NormanStaub/naub/firmware/v2/README.md

# naub V2 firmware toolkit

Everything learned from the display/grayscale/motion bring-up experiments
(2026-09, Windows host), packaged as reusable modules for building the real
UI. CircuitPython 10.3.0 on the Waveshare RP2350-Tiny.

```
device/   modules that live on the CIRCUITPY drive (pure CircuitPython)
  boot.py      enables the 2nd USB CDC (data) port -- needs a POWER CYCLE
  st7565.py    ST7565R driver: full-frame, partial-span, FRC-friendly
  link.py      host<->device line protocol over the data port
  naubhw.py    board wiring: display, backlight, 4 encoders, 9 switches
  gfx.py       1-bit page framebuffer + text/icon drawing (runs on PC too)
  mixer.py     the mixer screen: 3 columns, 8-band dot meters, the mode bar
  drawer.py    the app switcher: a dropdown over the meters (pure Python too)
  media.py     transport keys over USB HID -- no library, no host software
  idle.py      backlight: full while in use, 10% after 1 min, off after 5
  wheel.py     which apps the switcher offers, and for how long
  ballistics.py how every meter moves: one home for FALL/PEAK_FALL/PEAK_GAP
  config.py    the CONFIG screen: settings in tabs, driven by the three knobs
  ccfont.py    C&C Red Alert font (TINY h8 full ASCII, SML h16, BIG digits h27)
demos/    ready-to-flash examples (each becomes code.py) + generated data
  demo_mixer.py       the mixer screen + the app-switcher dropdown  <- the UI
  demo_app_icons.py   open-app icons in 4-plane FRC grayscale (static screen)
  demo_gray_modes.py  8 grayscale techniques on one knob (the experiment)
  demo_ball.py        bouncing ball, dirty-span updates (refresh/motion test)
host/     PC-side tools (Python 3 + Pillow, pyserial optional)
  deploy.py       python deploy.py mixer|icons|gray|ball -> copies to K:, watches serial
  frc.py          THE reusable piece: ink levels / PIL image -> FRC bitplanes
  naub_bridge.py  streams real audio to the device; applies knob moves back
  appmeter.py     per-app audio level / volume / mute from WASAPI
  appscan.py      enumerate open apps + extract their icons (Windows)
  gen_switcher.py regenerates demos/switcher_data.py (movable per-tier icons)
  gen_appicons.py regenerates demos/appicons.py (one baked screen)
  gen_grad.py     regenerates demos/graygrad.py (gradient planes)
  gen_font.py     TTF -> ccfont.py (extract repo-root c_c_red_alert_inet.zip
                  into host/font_src/ first)
  preview_mixer.py / preview_drawer.py / preview_gray.py      previews
  gdifont.py      render text with Windows GDI -- reaches BITMAP (.FON) faces
  preview_fonts.py  candidate faces at panel scale -> fonts_preview.png
  draw_logos.py / gen_icon.py                                 binary icons
```

## Display: ST7565R (EA DOGM128W-6, 128x64 STN)

Pins: A0=GP8 CS=GP9 SCL=GP10 SI=GP11 RST=GP12, backlight FET on GP13 (PWM).

The white backlight is also the part that wears out: Display Visions rate the
yellow/green, red and amber at 100,000 hours and say the white and blue are
"considerably shorter", recommending they be dimmed or switched off whenever
possible. The idle fade below is that recommendation, automated.

The backlight dims itself (`device/idle.py`): full while you are using it,
10% one minute after the last knob or key, off after five, fading between —
1.2 s down, 0.1 s back up, because settling should be unhurried and waking
should not. The fade interpolates in perceptual space (duty ** 1/2.2), since a
straight line in PWM duty looks like it plummets and then dawdles. The panel
keeps drawing the whole time; only the light goes.
Init = EA "single supply 3.0/3.3 V" sequence (see `st7565.py`). Config knobs
on the constructor / `naubhw.display()`:

| knob | default | notes |
|---|---|---|
| `baudrate` | 8 MHz | verified clean on hardware; 4 MHz also fine |
| `contrast` | 31 | user-tuned for FRC grays at BL 80% (26 tested at BL 100%) |
| `orient_180` | True | panel is mounted upside-down in the case |
| `col_offset` | derived | **must follow the orientation** — see below |

**`col_offset` depends on `orient_180`.** The ST7565R has 132 columns of RAM but
this panel wires only 128 of them, as SEG4..SEG131. With ADC reversed (`0xA1`,
the non-flipped case) column address 0 lands on SEG131, so the window starts at
0; with ADC normal (`0xA0`, the flipped case) it lands on SEG0 and the window
must start at **4**. Hard-coding 0 shifts the image 4px and paints 4 columns of
stale RAM at one edge — invisible on screens with blank margins, glaring on one
that draws edge to edge, which is how the mixer screen finally exposed it.
Leave `col_offset=None` and the driver derives it.

Framebuffer: `bytearray(128*8)`, `index = page*128 + x`, bit `1<<(y&7)`,
LSB = top. `gfx.py` is pure Python and runs identically on CPython, so PC
previews are pixel-exact (WYSIWYG workflow — always preview before flashing).

### Measured performance (RP2350-Tiny, CircuitPython 10.3.0)

| operation | rate |
|---|---|
| full-frame `show_pages()` @ 8 / 16 / 32 MHz | 572 / 900 / 1175 fps |
| full-frame `show()` @ 8 MHz (slices per page — allocates) | 463 fps |
| raw 1024-byte SPI write @ 8 MHz (the floor) | 1.31 ms |
| partial `span()` (16px sprite, 2 pages) @ 8 MHz | ~2200 updates/s |
| `drawer.compose()` open / mid-slide | 0.41 ms / 4.2 ms |
| `mixer.draw_dots()` (24 bands + peak markers) | 1.2 ms |
| `mixer.update()` + `draw_dots()` together | 4.5 ms |
| `eqscreen.update()` + `draw_plot()` (meter only) | 3.7 ms |
| poll 4 encoders + 9 switches | 0.056 ms |
| whole UI, paced to the panel (was 359-390 free-running) | 92.3 Hz |
| `time.monotonic()` granularity at 1.5 h uptime | 0.488 ms |
| `time.monotonic_ns()` granularity | 0.122 ms |
| USB CDC receive ring | ~200 bytes |
| free RAM with mixer + switcher loaded (8 apps, 2 tiers) | 358 kB |

**The panel refreshes at ~77 Hz, and that is a hard cap.** The ST7565R scans
the glass from its own RC oscillator (fOSC 20 kHz typ, 17-24 min/max) and at
1/65 duty the liquid crystal frame rate is `fOSC / (4 * 65)` = **76.9 Hz typ,
65-92 Hz over tolerance** (ST7565R datasheet Tables 19 and 23). It free-runs,
unsynchronised to our writes, and cannot be changed — an external clock needs
CL/CLS and the DOGM128 module does not bring them out. Everything above is a
data-delivery rate: at 360 fps we rewrite the RAM ~4.7 times per displayed
frame. Nothing faster than ~77 Hz can appear as a distinct frame, which is
exactly the effect the FRC grayscale exploits.

The practical consequence: the 16 ms UI tick (62.5 Hz) is already within a
whisker of the ceiling. Shortening it buys at most ~20% more distinct frames
before the glass, not the code, becomes the limit.

So the frame loop is **paced to 92.3 Hz** — the top of the panel's tolerance,
so a fast part is still fed everything it can show, and nothing is spent on
frames no panel could display. It free-ran at 359-390 fps, i.e. it rewrote the
controller's RAM about five times per displayed frame. Two things the pacing
had to get right:

* **Paced per push, not per cycle.** The FRC grays *are* the share of time each
  plane spends on screen, so idling at the end of a cycle — holding the last
  plane through the gap — would tint them. One plane, one slot: 92 Hz for a
  binary screen, 4 × 92 for the drawer.
* **Timed in `monotonic_ns()`.** Every pacing loop tried (single sleep, sliced,
  sleep-then-spin) landed on 96.2 Hz instead of 92.3, which looked like a bug in
  the loop and was the clock — see below.

And one consequence: the idle time has to be spent, not just slept through. The
USB CDC receive ring holds ~200 bytes and the host's resync burst fills it, so
the loop wakes every 2 ms to empty the port and parses the lines on the next
frame. Backlog on connect went from 200 bytes to 25 in steady state.

### What runs where

The split is not "whatever is easiest": the host is somebody's PC doing other
work, and the panel has a whole core idle between frames.

| | where | why |
|---|---|---|
| WASAPI sessions, volume, mute, per-app peaks | host | only Windows has them |
| Column assignments (pins) | host | must outlive a device reload, and every deploy is one |
| **Which apps the switcher offers** | **device** | per-app timers at a few Hz — the host would have to keep the same state and stream its conclusions |
| Meter ballistics, marquee, easing, FRC | device | pixels are the device's job |
| EQ response curve | device | 3 biquads evaluated on a 128-column grid, redrawn per detent |
| EQ filtering itself | host | Equalizer APO is the engine; the panel is its control surface |
| System spectrum (FFT) | host | needs the audio; **only runs while the EQ screen is up** |

Measured, streaming to a live panel (4 s samples, one app playing):

| panel is showing | sends / 4 s | bytes/s |
|---|---|---|
| mixer, switcher shut | `meter` 126, `ameter` 19 | 457 |
| mixer, switcher open | `meter` 126, `ameter` 126 | 728 |
| EQ screen | + `smeter` 125 | 2341 |

`ameter` drops to 5 Hz with the switcher shut because that is all the device
needs to time how long each app has played — 85% fewer sends, and 85% fewer
per-app peak polls on the PC, for no visible difference. The loopback capture
starts and stops with the EQ screen: measured **62–79 ms to start**, inside the
220 ms mode wipe, so the spectrum is there by the time the screen finishes
sliding in.

### The CONFIG screen

**Adding settings: see [CONFIG_MENU.md](CONFIG_MENU.md).** What is still a
placeholder, and what is not built at all: [STATUS.md](STATUS.md).

The fourth mode. Three knobs, three jobs, labelled across the top of the screen
because that is the affordance: **ENC1 the tabs, ENC2 the cursor, ENC3 the
focused value** — turned live, with no arming and no commit step. A hidden edit
mode is what makes people change settings they did not mean to, and there is no
room on 128×64 to show which state you are in.

A setting is a tuple, and adding one is a line:

```python
(name, kind, key, spec, default, art)
('DISPLAY VIEW ANGLE', ENUM, 'view_angle', ANGLES, 4, ANGLE_ART)
```

`spec` is whatever the kind needs (ENUM a tuple of labels, PCT a `(lo, hi,
step)`, BOOL nothing, INFO the string). Exactly one function knows what a kind
looks like and one more knows what a detent does to it; nothing else has a
special case. `key` is a string from the start, because the row order will
change and position is the wrong handle the day a value is sent to the host or
written to disk. `art` is a tuple of pictures indexed **by the value** — the
whole view-angle flipbook is `art[val]`, no logic.

Rows are **16 px, which is two pages**: name on the top line, marker and value
below, a picture spanning both on the right. Two rows show in full and a third
shows its top half, which is also how you can tell there is more below. Because
16 is a multiple of 8, scrolling a whole row is still a byte-slice blit — the
same reason every other screen here is cheap.

Nothing on this screen is on a timer. The mixer and EQ redraw on a 16 ms tick
because their meters move; a settings list changes when a knob does and not
otherwise, so it redraws on input and the loop pushes the same bytes in
between. Measured on the board: full render 4.6 ms, a SCROLL detent 0.8 ms, a
SELECT detent 3.4 ms (it rebuilds that row's strip), and the screen costs
7.5 kB with 322 kB still free.

`DISP > ADVANCED DISPLAY` is a submenu (SELECT-click to enter, MENU NAV to
leave) holding the ST7565R registers the bring-up swept by hand — contrast,
resistor ratio, bias, booster, invert, all-pixels-on, start line. They are
**live**: turning the knob writes the register. Every value of every one has
been swept on the hardware; two of them (contrast 0, ALL PIXELS ON) black the
panel out, and the way back is the knob you just turned, since the cursor does
not move. BRIGHTNESS drives the real backlight.

`DISPLAY VIEW ANGLE` **is the contrast register**, mapped: measured 25 looking
down at the panel on a desk, 40 from an extremely shallow angle, interpolated
over nine steps. The two rows agree in both directions — the friendly one
writes the raw one, and turning the raw one moves the friendly one to whatever
it now means. Panel default contrast is 25, top and bottom of that same range.

`SYS > GITHUB` is a **card** — a page that is a picture rather than a list. It
shows the repo's QR code beside the link it encodes,
`https://github.com/NormanStaub/naub`. Both, not either: the code is the point
on a panel with no keyboard, but a QR is unreadable to a person, so if it will
not scan — or you are looking at a photograph of the panel — the text is the
only thing that says where it goes.

The code is drawn at **one pixel per module**, which is not a choice. 37 modules
(a version-3 code plus the 4-module quiet zone the spec requires) is already 37
of this window's 40 pixel rows, so there is no room to scale it and it has to
earn its scannability from contrast rather than size. `host/gen_qr.py` bakes
`device/qrdata.py` from `firmware/naub_qr-code.png` and **verifies what it is
baking** — a QR is opaque, so shipping the wrong URL is a mistake you would
otherwise find with a phone. The rendered framebuffer has been decoded back to
the URL as a test.

`SHADING` cycles the grayscale modes from the bring-up experiment, with a
little waving flag beside it that **cycles while the row is highlighted** — a
black-to-white gradient in a band displaced by a sine, 16 phases of it.

The gradient is `host/frc.py`'s encoder transcribed onto the device, so the
patch shows what the switcher's icons will actually look like rather than an
impression of them — which is why the config screen runs **four FRC planes**.
The modes offered are the frame counts that divide that cycle (`1F SPATIAL`,
`2F TEMPORAL`, `4F HYBRID`); a 3-frame pattern inside a 4-frame loop repeats a
frame and shows the wrong grey. Nothing is wired to the setting yet.

Measured with the flag on screen: an **85 Hz grey cycle**, above the panel's own
77 Hz. Getting there meant redrawing only the list for animation frames
(`render()` on all four planes is 21 ms and dropped it to 62 Hz), composing the
list once into a scratch rather than per plane, and hoisting the patch
overlay's page arithmetic out of its column loop (4.9 ms → 2.4). When no grey is
on screen the loop pushes one plane instead of four.

The list **scrolls smoothly**, which is the one place this screen leaves the
page grid: mid-slide the window sits at an offset that is not a multiple of 8,
so the blit shifts bits and costs 7.7 ms against 1.9, for the dozen frames a
scroll lasts. It still fits the 10.8 ms the loop is paced to. A tab or submenu
change snaps instead — sliding between two different lists is motion that means
nothing. DIM AFTER and the SYS/OS rows remain
placeholders in the right shape, so the list, the scrolling and the tabs have
something to be tested against.

### One program is not one session

Discord runs six processes and holds a render session from more than one of
them; measured in a call, pid 5724 was ACTIVE with a peak of 1.0 while pid
14168 sat idle at 0.0. `appmeter` used to key a dict by program name and
*assign* into it, so it kept whichever the enumeration returned last — measured
six times out of six, the idle one. That is the whole of "Discord is in the
list but has no level and the knob does nothing".

Sessions are now grouped per program: the level is the loudest of them, and a
volume or mute goes to **all** of them, because which one is audible changes
from call to call. Reproduced deterministically with two same-named processes,
one silent and one playing, the silent one enumerated last:

```
pid 36340 ACTIVE peak 0.000     OLD (kept the last session)  -> level 0.000
pid 40632 ACTIVE peak 0.275     NEW (loudest of the group)   -> level 0.559
```

All output endpoints are enumerated too, not just the default — apps can be
pointed anywhere and this machine has fifteen active ones. That is also the
cheaper path: pycaw's `GetAllSessions()` rebuilds its COM plumbing per call and
measured **15 ms for one device**, while holding the session managers and
sweeping **all fifteen measured 3 ms**.

Hold those managers with `QueryInterface`, never `ctypes.cast` — cast
reinterprets the pointer without taking a reference, so when the `IUnknown` it
came from is collected COM frees the object and every cached manager is left
dangling. That crashed the bridge with an access violation minutes later,
nowhere near the cause.

### The switcher's list is the device's, not the host's

The host reports what is streaming. The device (`device/wheel.py`) decides what
is worth **offering**:

* an app must be audible for **4 s within one run** (a run being broken by 2 s
  of silence) before it earns a place — a notification chime is one to three
  seconds and does not come back, so it never qualifies;
* once earned, the place is held for **10 minutes** after it goes quiet, so
  pausing a track or closing the player does not take the entry away.

Verified on the hardware — the console logs the list, `*` meaning held:

```
wheel: CHROME, PYTHON      1.4 s chime playing
wheel: CHROME              ... and gone the moment it stops
wheel: CHROME, PYTHON      9 s stream playing
wheel: CHROME, PYTHON*     ... held after it stops
```

**Assignments are a separate thing.** A column pinned to an app keeps it when
the app closes, when the board reloads and when the bridge restarts (the pins
live in `%LOCALAPPDATA%\naub\pins.json`); relaunch the app and the column
controls it again. It does not reappear in the wheel while it is gone. And one
app can only be in one column: assigning an app another column is pinned to
swaps the two, on both sides, because two columns driving one fader would
fight.

### Never time anything with `time.monotonic()`

This build uses **single-precision floats** (`2.0**1023` is `inf`; at 5700 s
uptime `t + 1e-6 == t`). `time.monotonic()` returns seconds since boot as one
of those, so its granularity is the float spacing at the current uptime — and
that **doubles every time the uptime doubles**:

| uptime | `monotonic()` granularity |
|---|---|
| 1.5 h | 0.488 ms (measured) |
| 3 h | ~1 ms |
| 1 day | ~8 ms |
| 1 week | ~125 ms |

On a desk device that stays plugged in, a 16 ms tick timed against that clock
eventually stops being a tick. **`time.monotonic_ns()` is an integer of
nanoseconds and does not decay** (granularity 0.12-0.15 ms, from the tick
source). Every clock in `demo_mixer.py` and `device/idle.py` is `_ns` for this
reason: the frame pacing, the meter tick, the marquee, hold-to-mute, the host
liveness timeout and the backlight fades.

**What limits the frame rate below that.** Not the panel interface. A full frame
costs
1.75 ms of the ~2.7 ms the UI spends on one, and the SPI clock could be
doubled for another 0.6 ms — the redraws are the rest, and they run on a
16 ms tick — which is a rate the code asks for and does not get. That gate can
only be *tested* when a frame comes round, so it fires on the next whole frame
at or after 16 ms: 18.4 ms while the loop was free-running at 380 fps, 21.7 ms
now that a frame is 10.8. The meters have always run at 46 Hz, not the 62.5 the
constant names.

**Which is why the eased animations state milliseconds.** A fraction of the
remaining distance applied once a frame states a speed *per frame*, and the
frame rate is not a constant of the design — pacing the loop to the panel made
the drawer's fall and the shelf's scroll four times slower without anyone
touching a number. `DROP_MS`, `SCROLL_MS` and `WIPE_MS` say the duration;
`_ease()` derives the per-frame fraction from `FRAME_NS` once at import. If you
add an animation here, add it that way.

Two consequences worth remembering: pushing the same frame 300 times a
second buys nothing, and the cheapest optimisation available is always to stop
redrawing something that did not change. Latest example: the EQ screen was
rebuilding its header on every meter tick — three labels that had not moved,
3.3 ms out of every 16, worth **278 -> 380 fps** to skip.

Keep hot loops allocation-free (prebuilt page commands, `make_views()`
memoryviews, reused buffers) — GC pauses show up as visible flicker. The trap
worth naming: **a bytearray slice on the right of an assignment allocates a
copy.** `fb[o:o+128] = pan[p*128:(p+1)*128]` measured 4.6 ms for one drawer
frame; hoisting the right-hand side into prebuilt memoryviews took the same
work to 0.41 ms. Slice the *destination*, never the source.

## Grayscale: 4-plane FRC (the picked recipe)

The ST7565R has no hardware grayscale, but the STN panel's slow LC response
(tens of ms) acts as a temporal low-pass: cycle N bitplanes fast and a pixel
on in k of N frames reads as gray k/N. `demo_gray_modes.py` compares 8
techniques; **the winner on hardware was "GRAD 4F": N=4 planes (5 levels),
Bayer-dithered residual, phase rotated by (x+y)%4, contrast 31.** At 8 MHz
that cycles at ~138 Hz — a faint shimmer/static remains (the user likes it as
a texture; per-pixel random phase would randomize it, untested). 6 planes
(7 levels) shimmer more; 2 planes are steadiest but only 3 levels.

Encode on the PC with `host/frc.py`:

```python
import frc
planes = frc.encode_image(pil_image, n=4)        # or frc.encode(ink_rows)
frc.emit_module('demos/mydata.py', planes)       # device-importable bytes
frc.avg_image(planes).save('preview.png')        # what the panel will show
```

Display on the device (see `demo_app_icons.py` — this loop IS the UI core):

```python
views = [disp.make_views(fb) for fb in mydata.PLANES]
while True:
    disp.show_pages(views[i]); i = (i + 1) % len(views)
    # ...poll encoders between frames...
```

`frc.encode(..., ox=, oy=, planes=)` composites into existing planes with
screen-global dither coordinates, so regions tile seamlessly — build mixed
screens from parts.

## The mixer screen (`mixer.py` + `demo_mixer.py`)

Three app columns, each with a volume bar, a name, and a dot level meter for
what that app is playing, over a two-page mode bar.

```
| ####----- | ######--- | ########## |  volume bar    page 0
| CHROME    | MUSIC     | SPOTIFY    |  name, marquee page 1
| -   - -   | -     -   |            |  7 bands per column, standing on
| :   : :   | :     -   |            |  the floor and bouncing UP, each
| : : : : : | : : : : : |            |  with its own peak marker riding
|------------------------------------|  its leading edge   pages 2-6
| APP CTRL |||       SYS. #########   |  mode bar      page 7
```

**Both text bars are exactly one page tall**, each carrying its rule on the row
that divides it from the meter: the names bar has its rule at the bottom of its
own page (y15), the mode bar takes the last row of the meter band (y55). That
is why `draw_dots` clears the meter's final page *to* the rule — the line above
the mode bar then costs nothing. The mode bar's label is pushed down one row
(`FOOT_SHIFT`) so it clears that rule, mirroring the 1 px the names bar leaves
above its own.

### Controls

| input | action |
|---|---|
| ENC1-3 turn | that column's app volume |
| ENC1-3 click | open the app switcher for that column; click again to assign |
| ENC1-3 hold 0.6 s | mute / unmute that column |
| ENC4 turn / click | system volume / system mute |
| BTN1 / BTN2 | previous / next mode |
| BTN3 / BTN4 / BTN5 | `\|<<` `>\|\|` `>>\|` — media transport, over HID |

BTN3/4/5 are the bottom row of keyswitches (SW7/8/9, GP20/21/22), left to
right. They go out as **USB HID Consumer Control**, not over the line protocol,
so they work with no host software running — see `device/media.py` and
PROTOCOL.md §11. Verified with a `WH_KEYBOARD_LL` hook: all three land as
`MEDIA_PREV_TRACK` / `MEDIA_PLAY_PAUSE` / `MEDIA_NEXT_TRACK`.

### The mode bar

Two pages tall, so the text has room to breathe, and it names the current
**mode** rather than a fixed preset. The `|||` between the label and `SYS.` is
not decoration — it is the position in the mode list:

```
   APP CTRL |||          mode 1 of 4
 | EQ        ||          mode 2
|| CUSTOM 1   |          mode 3
||| CUSTOM 2             mode 4
```

There is always one tick fewer than there are modes, and the current mode
splits them: ticks left of the label are the modes behind you, ticks right the
ones ahead. Flipping a mode redraws the bar and that is the entire transition —
there is nothing to animate, which is why it feels instant.

**The ticks sit on a fixed lattice** and never move to accommodate the text —
a position indicator that shifted with the length of the name would indicate
nothing. Think of it as `n` slots in a row: `n-1` hold a tick and one holds the
label, and advancing a mode swaps the label with the tick on its right. The
label is left-justified in a field as wide as the longest mode name, so exactly
two things move: one tick hops to the other side, and the label's leading edge
steps right by exactly the space that tick now occupies (`TICK_PITCH`, 3 px).
With the current list every tick is on x = 1, 4, 7 (behind) or x = 45, 48, 51
(ahead), whatever the label says.

**That hop is animated, and the animation falls out of the geometry** rather
than being bolted on. Every tick has exactly two homes, one per side of the
label, and is on the left one precisely when it is behind the current mode. So
give each a crossed-ness from 0 (right) to 1 (left), ease it toward its target
and place it between its two homes: one mode step wipes a single line across
the label, and a wrap from the last mode to the first sweeps all of them back
at once. The label's own x is the **sum** of those crossed-nesses times the
pitch, so it slides in step with the lines pushing it — there is no separate
label tween to keep in sync. `Mixer.set_mode()` starts it, `step_foot()` runs
one frame and returns False when it settles; 15 frames at the 16 ms tick, so
about a quarter of a second.

Only **APP CTRL** is implemented. `EQ` has its verbs defined (PROTOCOL.md §10)
but no V2 screen yet, and `CUSTOM 1/2` are placeholders; flipping to them moves
the ticks and the label and leaves the mixer up. The switcher opens only in
APP CTRL, since that is the mode it belongs to.

The mode bar is the one thing on this screen that is **not** page-aligned: its
text and its system-volume bar straddle pages 6 and 7 so they sit centred in
the taller bar, which costs a shift per column byte. That is fine — it is
redrawn only when something in it changes, never in the frame loop.

### What Windows can and cannot tell us

- **Per-app level: yes.** Every WASAPI session exposes
  `IAudioMeterInformation::GetPeakValue()` — a real amplitude trace of that app
  alone, at ~0.05 ms per session, so 100 Hz polling is free. pycaw does not
  wrap the interface; `host/appmeter.py` declares it.
- **But the peak is the *raw stream*.** Measured on this box: it does not move
  when the session volume changes, nor when the endpoint volume does — it is
  what the app rendered, before anybody's fader. A meter built on it alone
  would sit still while you turn the knob, which is not what a mixer meter
  means. `levels()` therefore scales by the session's **own** volume and reads
  zero when muted. The **system** volume is deliberately left out: that is not
  this app getting quieter.
- **Curve first, fader second.** The gamma is applied to the peak and the
  volume multiplies the result, not the other way round. The curve exists to
  lift quiet program material into view; running the fader through it too would
  compress the knob (half volume would read as 0.73 of full height instead of
  half). Verified against a steady tone: 0.75 / 0.50 / 0.25 on the fader give
  exactly ×0.75 / ×0.50 / ×0.25 on the meter, mute gives zero, and moving the
  system fader changes nothing.
- **Per-app spectrum: no.** There is no per-session tap — WASAPI loopback
  captures the endpoint *mix*. A per-app FFT would need code injected into
  every process. So the band shape is **faked** from the one amplitude we do
  get — see "The meter" below.

Peak is linear amplitude, which looks dull on a small panel because speech and
music sit low in the range, so `appmeter.levels()` applies a gentle curve
(`curve=0.45`); pass `1.0` for raw.

### The meter

Each column is a **mixer meter with 7 bands**. Every band stands on the floor,
rises with its share of the level, and carries a short line at its leading edge
— the **peak hold**, which jumps straight to any new peak and then settles back
down smoothly, detaching from the falling band. The dot texture is anchored to
the bottom too, so the dots stay put as a band grows instead of crawling.

- **Ballistics** are fast-attack / slow-release on both (`mixer.FALL`,
  `mixer.PEAK_FALL`, tuned for a 16 ms tick); the peak falls ~6x slower than
  the band. That asymmetry is what makes a meter look alive rather than jittery.
- **The run is centred in its column**, which constrains the numbers: it is
  `(NBAND-1) * BAND_PITCH + BAND_W` wide and the leftover has to be *even* for
  the margins to match. **7 bands at pitch 6** span 38 of the 42 px column, so
  the margin is exactly 2 either side. (8 bands at pitch 5 span 37, leaving an
  odd 5 — 2 px one side and 3 the other, which is what made the meter look
  adrift in its column.)
- **Height is in pixels, not rows.** A band fills any of 0..40 px, so motion
  moves at the finest step the panel has. The dot texture comes from the *fill
  pattern* (2px lit, 2px clear) rather than from quantising the height.
- **The spectrum is faked**, because the host can only report one amplitude per
  app. Bands get a gentle tilt (`TILT`, lows louder) times a per-band random
  walk that is *smoothed* rather than re-rolled each frame (`NOISE_KEEP`,
  `NOISE_GAIN`) — so they drift and bounce independently instead of flickering
  like static.

Every band height is precomputed as page byte masks (`BAND_PAGES`), so drawing
a band is a few ORs into a per-column scratch buffer that is slice-copied
straight into the framebuffer. The scratch overwrites every byte of a column,
so there is no clear pass, and the separators sit in the 1px gaps *between*
columns where the hot path never touches them — chrome is drawn once.

### Binary, and therefore single-plane

**This screen is drawn pure binary**: every element is fully inked or absent,
because a part-duty area of any size visibly flickers. So the bar's range is a
1px baseline rather than a gray track, and a muted bar is a hollow outline
rather than a dimmer fill.

Being binary means **one framebuffer suffices** (`Mixer(font, n=1)`, the
default): nothing to cycle, so no FRC shimmer at all, and a quarter of the
drawing work. Measured **391 fps — i.e. 391 Hz of real refresh**, against
100 Hz of gray cycle when the same screen was drawn across 4 planes. Pass
`n=4` if you reintroduce gray elements. The switcher's icons are still FRC
grayscale, so `demo_mixer.py` re-reads `len(views)` whenever the dropdown opens
or closes: 1 plane for the mixer, 4 while the drawer is out.

### Why it is cheap to animate

- every possible band height is precomputed as page byte masks (`BAND_PAGES`),
  so drawing a band is a few `|=` into a per-column scratch buffer that is
  slice-copied straight into the framebuffer;
- names render once into a one-page `gfx.text_strip()` and the **marquee is a
  byte-slice window** into it, so scrolling a long name is free — this is why
  `ccfont.TINY` is exactly 8 px tall;
- the scratch overwrites every byte of a column, so there is no clear pass, and
  the separators sit in the 1 px gaps *between* columns where the hot path
  never touches them — chrome is drawn once, at construction.

A full meter redraw (24 bands + peak markers) costs 1.2 ms against a 2.7 ms
single-plane frame, and it only runs on the 16 ms tick.

### The font

`ccfont.TINY` is **Small Fonts at height 8** — a Windows *raster* face, drawn by
hand at fixed pixel sizes, not an outline scaled down. Cropped from row 1 it
gives 5 px caps inside one page and renders SPOTIFY in 29 px, and it is drawn
with `spacing=0` (`mixer.SPACING`).

That distinction is the whole game at this scale. An outline face rasterised to
a 5–6 px cap height loses strokes and joins others no matter how well hinted —
Tahoma's `A` arrives with no crossbar — while a raster face has every pixel
where its designer put it. PIL/FreeType **cannot open a `.FON` at all**, which
is why the first survey never considered them; `host/gdifont.py` renders them
through GDI instead, and `gen_font.py --list` shows which faces are raster
(`gdi`) and which are outlines (`ttf`).

A raster face must be asked for a height it actually ships, or GDI scales a
strike it does not have and the problem comes straight back; `gen_font.py`
refuses rather than doing that. Small Fonts ships 5, 6, 8, 10–13 and 16.

TINY is generated **all-caps** (lowercase from its uppercase form): eight rows
will not hold ascenders, caps and descenders together at a legible cap height,
and the UI is uppercase throughout anyway.

```
python host/gen_font.py --list          # what faces are on offer
python host/gen_font.py --face tahoma   # ... try another
python host/preview_fonts.py            # all of them, side by side, at scale
```

```
python host/appmeter.py             # see the live per-app levels
python host/preview_mixer.py        # WYSIWYG check; --live drives it from real audio
python host/deploy.py mixer
```

## The EQ mode (`eqscreen.py` + `eqcurve.py`)

Three bands over a filled response curve, in the mixer's own three-column frame
— three top knobs, so three bands. LOW is a low shelf, MID a peak, HIGH a high
shelf: the tone-control split, written by the host as `LSC` / `PK` / `HSC`.

```
| LOW +1.5 | MID +0.0 | HIGH +1.0 |  band + gain, one per knob   page 0
|---------------------------------|
|  __O__   |         |            |  the curve, a handle on each band,
| ::::::::::  ___O___|_____:::::::|  over a dot fill hanging from it
|---------------------------------|  pages 1-6, 0 dB dead centre
| EQ ||            SYS. ######    |  mode bar stays put          page 7
```

- **0 dB is the vertical middle**, so flat is a straight line across the centre
  and the curve reads as deviation in both directions. 48 rows, so the centre
  lands *on* a row rather than between two.
- **Under the curve is a real meter of the system output**, not a decorative
  fill: 21 bands rising from the floor, styled exactly like the app meters —
  same 2px dots, same peak markers, same ballistics. It is also *accurate*,
  which the app meters cannot be: Windows exposes no per-session spectrum, but
  the endpoint can be captured, so `host/sysmeter.py` runs a real FFT on the
  WASAPI loopback and sends 21 log-spaced bands over. What you see is what is
  leaving the machine, past the EQ and past the mix.
  (The endpoint's own `IAudioMeterInformation` looked like the easy answer and
  is not — measured, it moves ×0.91 when the system fader drops to 0.30, i.e.
  it reports the stream *before* the volume, and it is one number rather than a
  spectrum.)
- **The separators stop at the curve**, which is what makes it read as a
  surface with the dots beneath rather than a line drawn over a texture.
- **Knobs:** ENC1-3 turn their band; click cycles what that knob edits —
  gain → frequency → Q — and the header cell shows whichever is live.
- **The curve is truthful, not illustrative.** `eqcurve.py` evaluates the RBJ
  cookbook coefficients Equalizer APO itself implements, checked against an
  independent numpy evaluation to 2e-11 dB. One knob detent costs 13 ms because
  only the band that moved is recomputed; a full rebuild would be 33 ms.
- **No engine, no pretending.** Equalizer APO attaches per *endpoint*, so it
  can be installed and still inert on the current output; the screen says
  `NO EQ ENGINE ON THIS OUTPUT` rather than drawing a curve that shapes
  nothing. See `EQ_PLAN.md` §2.

**Changing modes wipes**, right to left: a vertical line sweeps across and the
new screen follows behind it (`device/wipe.py`). In this framebuffer the byte
index *is* x, so a wipe frame is two slice copies per page — 1.5 ms — rather
than any per-pixel work. The mode bar is deliberately left out of it so its
ticks can run their own animation underneath: the ticks mean "where you are in
the list", the wipe means "the screen is changing".

Two measurements shaped the screen. Splitting the plot into a prebuilt curve
layer and a live meter layer took a tick from 9.4 ms to 3.3 ms — only a band
change moves the curve, while the meter moves 60 times a second. And caching
the header's text strips took `draw_head` from **11.8 ms to 3.3 ms**: six
strings rebuilt per frame were three times the cost of the entire meter and the
single biggest thing on the screen. Together: 105 fps → **352 fps**.

```
python host/eqapo.py            # engine status + the config it would write
python host/eqapo.py --check    # a full cycle leaves config.txt byte-identical
python host/preview_eq.py       # WYSIWYG check
```

## Live audio: the host link

**The bridge is not optional, and it is meant to stay running.** The panel is a
display; the host is the thing that talks to WASAPI. Without
`host/naub_bridge.py` there are no levels to show *and no way to apply a knob* —
turning one moves the on-screen bar and nothing else.

```
python host/deploy.py mixer     # ships device/boot.py too
#  ... FULLY POWER CYCLE the board (unplug/replug) ...
python host/naub_bridge.py      # leave this running
python host/naub_bridge.py --ports   # if it cannot find the data port
```

- **The levels are real, and the device will not pretend otherwise.** With no
  host talking, the meters sit **flat** rather than inventing a signal: a meter
  that moves when nothing is playing is a liar, and it hides the one thing you
  need to know, which is that the bridge is not running. `demo_mixer.SIMULATE`
  turns the fake envelope back on for UI work. The device also drops back to
  flat after `LIVE_S` (1 s) without a `meter` line, so a bridge that dies shows
  up immediately instead of freezing the meters at whatever was last playing.
- **Only the band *shape* is invented** — see "The meter" above. The amplitude
  driving all 7 bands is the app's real WASAPI peak.
- **The bridge reconnects by itself.** Every `deploy.py` reloads the board and
  drops the CDC link; a bridge that died there would leave the panel dark and
  silently stop applying knob moves, which looks exactly like a firmware bug and
  is not one. It re-finds the port, reopens it and re-pushes the whole state
  (`Bridge.resync`). `--once` opts out.

- **Why a second port.** Host->device writes on the *console* port hang on this
  board (bring-up finding), so `device/boot.py` enables a second USB CDC
  interface — the data port — and everything the host says goes over that.
  USB descriptors are fixed at enumeration, so boot.py needs a **power cycle**,
  not a reload. Until then `Link.ready` is False and the demo simulates.
- **Finding the port.** Windows reports the interface number inconsistently:
  on this board the console has `location=None` and the data port
  `location='1-10.3:x.2'`, while other setups tag the hwid `MI_00`/`MI_02`.
  `naub_bridge.find_ports()` handles both and otherwise just takes the lowest
  interface as console, highest as data.
- **Protocol** is V1's line protocol (PROTOCOL.md §11) plus four verbs:
  `meter <v0> <v1> <v2>` (column levels), `apps <A,B,C>` (every app with a live
  session — the switcher's list) and `ameter <v0> <v1> ...` (one level per entry
  in it), all pushed at `--rate`; `pick <ch> <APP>` comes back when the switcher
  assigns one. Knob moves still come back as `vol <ch> <0..100>` and
  `mute <ch> <0|1>`; channel 3 is the system/master, matching V1.
- **The host owns the column names, except where you pinned them.** It fills
  the columns from the most active sessions, but a `pick` pins that column and a
  pinned column is never reassigned by the host's churn
  (`naub_bridge.Bridge.columns()`). This was the open question left by the
  previous pass; the switcher is what closed it.

## The app switcher (`drawer.py`)

Not a separate screen: a **dropdown** that slides down out of one column's name
slot and covers the meter band. The volume bars and the mode bar never move, so
you never lose your place — and the column being edited is the one whose name
and rule are *missing*.

```
| ####----- | ######--- | ########## |  volume bars stay put   page 0
|           |  MUSIC    |  SPOTIFY   |  edited column blanked, rule gapped
|             SPOTIFY                |  selected name, full width  panel p0
|   [ic]     [ ICON ]     [ic]       |  icon shelf, TOP-aligned    panel p1-4
| o o O o o  [ ICON ]     .. .. |    |  counter and level FLANK it panel p4
|------------------------------------|
| APP CTRL |||       SYS. #########   |  mode bar stays put     page 7
```

Four pages is not much, and the layout is what buys the icons their size back —
24 px focused, 16 px either side, in a band only three pages tall:

- **the name gets the whole width.** It is the *selected app's* name, not a
  column heading, so nothing has to share the row and a long name has all
  128 px before it is trimmed;
- **the shelf is top-aligned, not bottom-aligned.** Every tier starts on the
  same page and the focused one simply reaches further down — that is what lets
  the focus be 32 px while its neighbours are 24 px;
- **the counter and the level flank the focused icon** rather than sitting
  under it, in the very row the tall icon is using. A row of their own would
  have cost the shelf a quarter of its height. `NEAR` is kept tight (0.18) so
  the 32 px tier never reaches either of them: at the tier edge the icon spans
  x 40–88, against a counter ending at 40 and a level starting at 88. The last
  row of that page is the rule the mode bar sits under, laid across the full
  width *after* everything else, so it never breaks where the tall icon stands
  — the icon reads as standing on the line.

- **The host never lists itself.** `sysmeter`'s loopback capture opens the
  render endpoint, which registers the host process as an audio session — so
  naub appeared in its own mixer as `PYTHON`, metering the system output it was
  capturing. `appmeter` skips its own PID: a tool should not show up among the
  things it controls.
- **The counter is honest.** One marker per app with a *live audio session*
  (`appmeter.active()`), filled at the current selection. Nothing playing means
  no markers — the dropdown still opens (a dead gesture is worse than an empty
  shelf), it just has nothing to assign. It drops from 5 px rings to 3 px
  markers when there are more apps than fit beside the icon.
- **The bottom row meters the selection, not the column.** It follows the
  scroll, so you see what you are about to assign. Same fast-attack /
  slow-release ballistics as the mixer's bands, with a peak tick on the leading
  edge.
- **Page-aligned size tiers.** `TIERS = ((32,1),(24,1))` — both a multiple of
  8 and starting on the same page, so an icon is `fb[o:o+w] = src[s:s+w]` with
  no bit shifting. The tier comes from the *fractional* distance to the focus,
  so easing `pos` toward an integer target produces the zoom for free.
  `PITCH = 42` puts exactly three icons on screen.
- **The blocks must match `TIERS`.** `Drawer` checks their length at
  construction and raises a clear error naming `gen_switcher.py`, because the
  failure otherwise is horrible: on the device `_blit` runs off a short block
  and raises `IndexError` from inside the frame loop, while on CPython the same
  short slice assignment silently **resizes** the destination bytearray — so
  the PC preview looks perfect and only the panel breaks. `deploy.py` now ships
  `switcher_data.py` with every deploy for the same reason.
- **The wipe carries a rule on its leading edge** — the last revealed rows are
  forced solid while the panel is moving, so it reads as a surface sliding over
  the meters rather than as content appearing out of nowhere. Two rows, not
  one (`wipe.EDGE_W`, shared with the mode change so the two agree): at the
  panel's default contrast of 25 a single row of ink, on the glass for one
  animation step, is most of the way to invisible. The extra row goes *behind*
  the edge, into the panel it has already revealed, so the boundary stays on
  `reveal` and the thickness reads as a trail.
- **Apps with no icon get a placeholder** — a rounded frame with the app's
  initial. The session list and the icon catalogue come from different places
  (apps making noise vs. apps with a window), so a mismatch is normal.
- **The mode bar is untouched** while the drawer is out. It already reads
  `APP CTRL`, which is the mode the switcher belongs to.

The panel composites over the live mixer frame: rows above the sliding edge are
the panel, rows below it are still the running meters, merged byte-wise on the
one page the edge cuts through. Measured **0.41 ms** to compose an open panel
and 4.2 ms on the frames where the edge is mid-page. Measured on hardware over
three open/scroll/close passes: **390 fps, 97 Hz of gray cycle**, steady.

Regenerate the icons for whatever you have open, then flash:

```
python host/gen_switcher.py      # -> demos/switcher_data.py (5 kB, 1.3 kB of pixels)
python host/preview_drawer.py    # WYSIWYG check; --live drives it from real audio
python host/deploy.py mixer
```

`drawer.py` imports nothing but `gfx`, so `preview_drawer.py` drives the exact
code the device runs — always preview before flashing.

## Motion

`demo_ball.py`: dirty-span partial updates hit ~2200 updates/s, so bandwidth
is never the limit — **the LC response is**. Fast motion motion-blurs/ghosts
(user-confirmed at 8 MHz: "ok albeit some ghosting"). Rule of thumb: keep
animated elements under ~300-500 px/s or embrace the smear. Partial updates
leave enough budget to cycle FRC planes AND move a sprite in the same loop.

## Inputs (all four encoders verified on hardware)

`naubhw.encoders()` -> ENC1 top-left, ENC2 top-middle, ENC3 top-right,
ENC4 lower-right. Non-negotiable lessons baked into `naubhw.py`:

- **`divisor=2`**, not the rotaryio default 4 — the PEC11L-4215F-S0015 is
  30-detent/15-PPR; divisor 4 skips every other detent.
- **GP16 is spent** (module's onboard WS2812). **GP17-GP23 are back-pad pins
  absent from `board.*`** — use `microcontroller.pin.GPIOxx` (ENC4 A/B/SW,
  ENC3_SW, BTN3-5). Already handled in `naubhw.py`.
- All switches/encoders ride internal pull-ups; there are deliberately no
  discrete pull-ups on the board (PCB_DESIGN.md 2.1).

## Host <-> device workflow (Windows)

- CIRCUITPY mounts as a drive (K: here) and read/write **works** on Windows
  (it did not on macOS — see BRINGUP_LOG.md). This is the deploy path.
- Copy order: support modules first, **code.py last** — every write triggers
  auto-reload; only the last one should run. `deploy.py` does this.
- Serial console (COM9): treat as **read-only for data.** Host->device writes
  were found to hang during V1 bring-up, so nothing streams over it — that is
  what the CDC *data* port is for. Two control bytes did get through in V2
  testing, though, and they are worth knowing about (see below).
- **A crashed `code.py` stops auto-reload.** An unhandled traceback drops
  CircuitPython to the REPL, and from there copying a new `code.py` changes
  nothing: the console goes quiet and the board looks wedged. Sending Ctrl-C
  then Ctrl-D over COM9 soft-reboots it and re-runs `code.py` — that recovered
  it without a replug. `tmp/reboot.py` in the job scratch does exactly this;
  keep `write_timeout` short in case the write does hang.
- **CIRCUITPY can go read-only to the host with nothing wrong on the board**
  (`Get-Disk` shows `IsReadOnly True`; `deploy.py` fails with `PermissionError`
  on the first file). Seen once, cause unknown: the firmware never remounts the
  drive. A soft reboot does not clear it. `microcontroller.reset()` from the
  REPL did, and a replug should too.
- If the ports enumerate but refuse to open right after a physical replug
  (`PermissionError: Access is denied`), that is Windows still tearing down the
  old handles. Wait a few seconds rather than assuming a fault.
