NormanStaub/naub/pcb/DFM analysis report_JLCDFM_naub_gerbers_jlcpcb.pdf

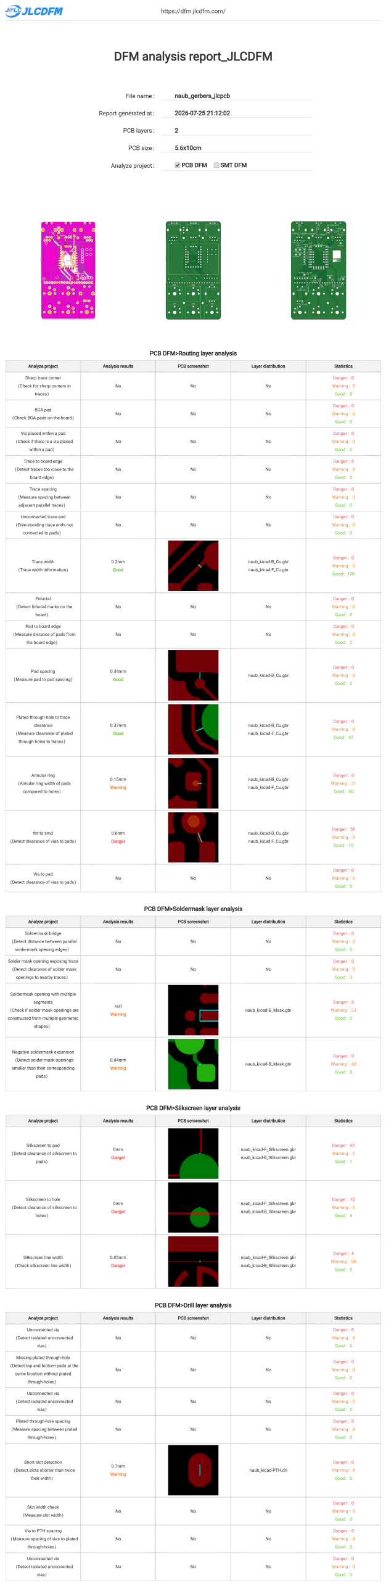
[picture p1: page 1]
