NormanStaub/naub/CAD/V2/naub_v2_layout3.dxf

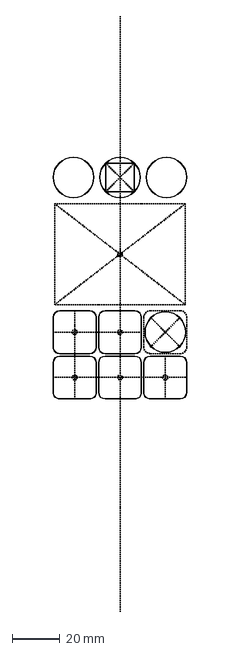
[picture p2: CAD file, 2026-07-25]
CAD/V2/naub_v2_layout3.dxf
56.0 x 249.8 mm
