NormanStaub/naub/CAD/V2/component_layout.dxf

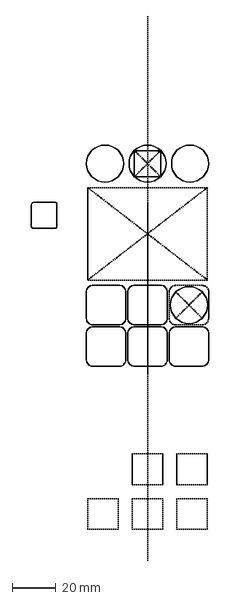
[picture p4: CAD file, 2026-07-25]
CAD/V2/component_layout.dxf
81.3 x 249.8 mm
