NormanStaub/naub/CAD/V2/naub_v2_layout2.dxf

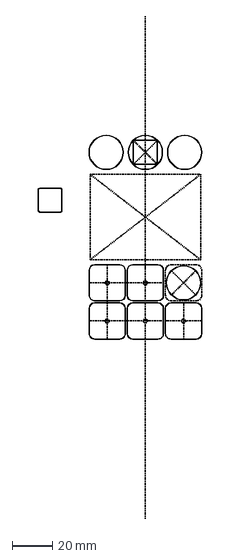
[picture p5: CAD file, 2026-07-25]
CAD/V2/naub_v2_layout2.dxf
81.3 x 249.8 mm
