NormanStaub/naub/pcb/naub_kicad.kicad_pcb

## KiCad design pcb/naub_kicad.kicad_pcb (2026-08-31)

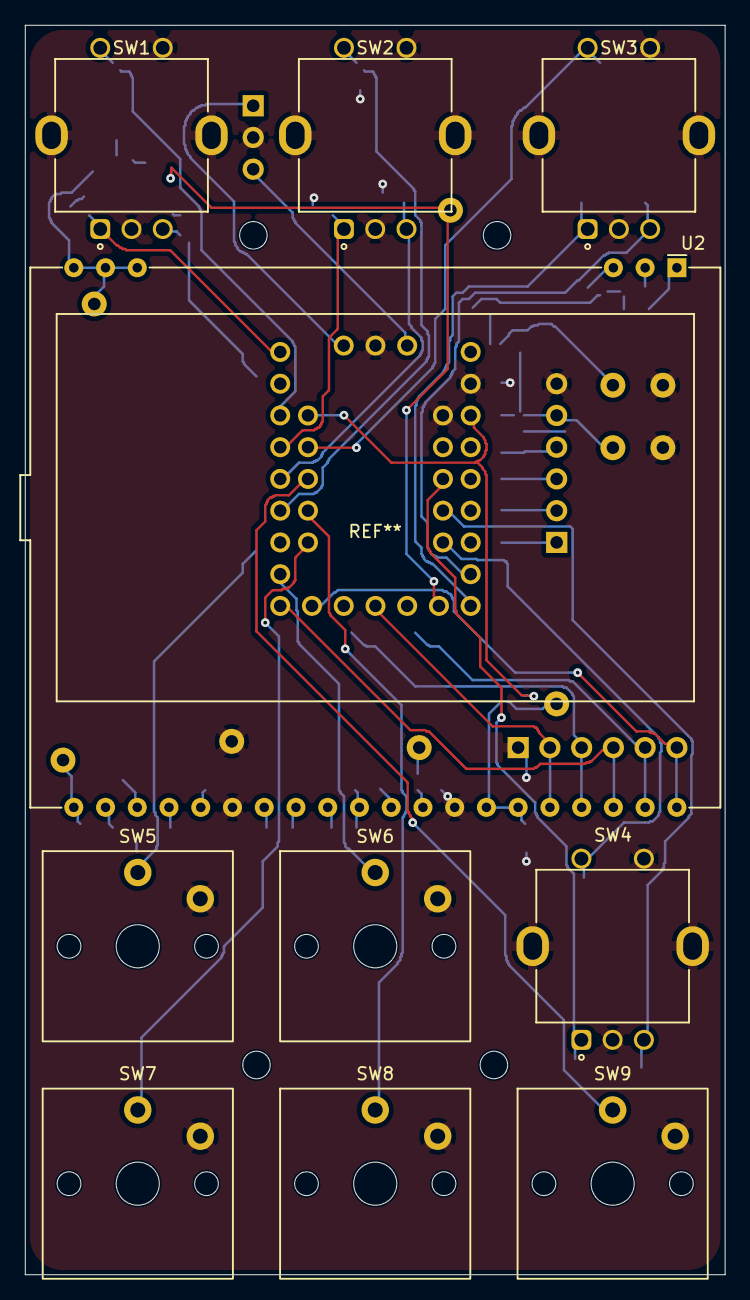
[picture p6: board naub_kicad.kicad_pcb from above]

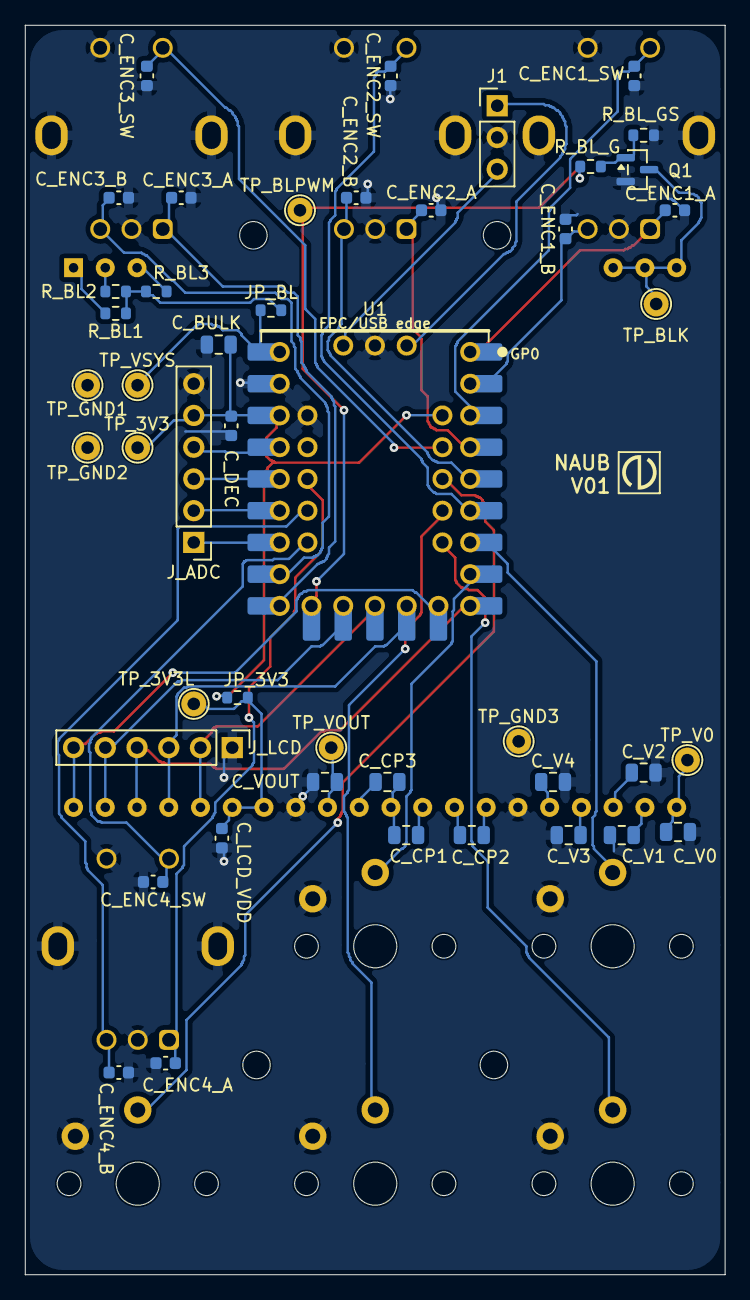
[picture p7: board naub_kicad.kicad_pcb from below]

Board: 2 copper layers, 56.0 x 100.0 mm, 56 parts (46 on the bottom side), 50 nets.

Parts:
C_BULK: 10uF; C_0805_2012Metric
C_CP1, C_CP2, C_CP3: 1uF; C_0805_2012Metric
C_DEC: 100nF; C_0603_1608Metric
C_ENC1_A, C_ENC1_B, C_ENC2_A, C_ENC2_B, C_ENC3_A, C_ENC3_B, C_ENC4_A, C_ENC4_B: 10nF; C_0603_1608Metric
C_ENC1_SW, C_ENC2_SW, C_ENC3_SW, C_ENC4_SW: 100nF; C_0603_1608Metric
C_LCD_VDD: 100nF; C_0603_1608Metric
C_V0, C_V1, C_V2, C_V3, C_V4: 1uF; C_0805_2012Metric
C_VOUT: 1uF; C_0805_2012Metric
J1: SWD; PinHeader_1x03_P2.54mm_Vertical
JP_3V3: 0R; R_0603_1608Metric
JP_BL: 0R; R_0603_1608Metric
J_ADC: SPARE_IO; PinHeader_1x06_P2.54mm_Vertical
J_LCD: LCD_DEBUG; PinHeader_1x06_P2.54mm_Vertical
Q1: 2N7002; SOT-23
R_BL1, R_BL2, R_BL3: 300; R_0603_1608Metric
R_BL_G: 100; R_0603_1608Metric
R_BL_GS: 10k; R_0603_1608Metric
SW1, SW2, SW3, SW4: PEC11L-4020F-S0020; RotaryEncoder_Bourns_PEC11L-4xxxF-Sxxxx_Vertical
SW5, SW6, SW7, SW8, SW9: Kailh_Choc_Red; SW_Kailh_Choc_V1
TP_3V3, TP_3V3L: TP; TestPoint_THTPad_D2.0mm_Drill1.0mm
TP_BLK: TP; TestPoint_THTPad_D2.0mm_Drill1.0mm
TP_BLPWM: TP; TestPoint_THTPad_D2.0mm_Drill1.0mm
TP_GND1, TP_GND2, TP_GND3: TP; TestPoint_THTPad_D2.0mm_Drill1.0mm
TP_V0: TP; TestPoint_THTPad_D2.0mm_Drill1.0mm
TP_VOUT: TP; TestPoint_THTPad_D2.0mm_Drill1.0mm
TP_VSYS: TP; TestPoint_THTPad_D2.0mm_Drill1.0mm
U1: Waveshare_RP2350-Tiny; Waveshare_RP2350-Tiny_Hybrid
U2: EA_DOGM128W-6; EA_DOGM128-6

Connections:
+3V3: C_BULK.1, C_DEC.1, JP_3V3.1, J_ADC.5, TP_3V3.1, U1.3V3
+3V3_LCD: C_LCD_VDD.1, JP_3V3.2, TP_3V3L.1, U2.34, U2.35
BL_A1: R_BL1.2, U2.1
BL_A2: R_BL2.2, U2.2
BL_A3: R_BL3.2, U2.3
BL_CATHODE: Q1.3, TP_BLK.1, U2.18, U2.19, U2.20
BL_PWM: R_BL_G.1, TP_BLPWM.1, U1.GP13
BL_PWM_GATE: Q1.1, R_BL_G.2, R_BL_GS.1
BTN1: SW5.1, U1.GP6
BTN2: SW6.1, U1.GP7
BTN3: SW7.1, U1.GP20
BTN4: SW8.1, U1.GP21
BTN5: SW9.1, U1.GP22
ENC1_A: C_ENC1_A.1, SW1.A, U1.GP0
ENC1_B: C_ENC1_B.1, SW1.B, U1.GP1
ENC1_SW: C_ENC1_SW.1, SW1.S1, U1.GP2
ENC2_A: C_ENC2_A.1, SW2.A, U1.GP3
ENC2_B: C_ENC2_B.1, SW2.B, U1.GP4
ENC2_SW: C_ENC2_SW.1, SW2.S1, U1.GP5
ENC3_A: C_ENC3_A.1, SW3.A, U1.GP14
ENC3_B: C_ENC3_B.1, SW3.B, U1.GP15
ENC3_SW: C_ENC3_SW.1, SW3.S1, U1.GP23
ENC4_A: C_ENC4_A.1, SW4.A, U1.GP17
ENC4_B: C_ENC4_B.1, SW4.B, U1.GP18
ENC4_SW: C_ENC4_SW.1, SW4.S1, U1.GP19
GND: C_BULK.2, C_DEC.2, C_ENC1_A.2, C_ENC1_B.2, C_ENC1_SW.2, C_ENC2_A.2, C_ENC2_B.2, C_ENC2_SW.2, C_ENC3_A.2, C_ENC3_B.2, C_ENC3_SW.2, C_ENC4_A.2, C_ENC4_B.2, C_ENC4_SW.2, C_LCD_VDD.2, C_V0.2, C_V1.2, C_V2.2, C_V3.2, C_V4.2, C_VOUT.2, J1.2, J_ADC.6, J_LCD.1, Q1.2, R_BL_GS.2, SW1.C, SW1.S2, SW1.SH, SW2.C, SW2.S2, SW2.SH, SW3.C, SW3.S2, SW3.SH, SW4.C, SW4.S2, SW4.SH, SW5.2, SW6.2, SW7.2, SW8.2, SW9.2, TP_GND1.1, TP_GND2.1, TP_GND3.1, U1.GND, U2.26, U2.33
LCD_A0: J_LCD.4, U1.GP8, U2.38
LCD_CAP1N: C_CP1.2, C_CP3.2, U2.30
LCD_CAP1P: C_CP1.1, U2.29
LCD_CAP2N: C_CP2.2, U2.27
LCD_CAP2P: C_CP2.1, U2.28
LCD_CAP3P: C_CP3.1, U2.31
LCD_CS: J_LCD.6, U1.GP9, U2.40
LCD_RST: J_LCD.5, U1.GP12, U2.39
LCD_SCL: J_LCD.3, U1.GP10, U2.37
LCD_SI: J_LCD.2, U1.GP11, U2.36
LCD_V0: C_V0.1, TP_V0.1, U2.21
LCD_V1: C_V1.1, U2.22
LCD_V2: C_V2.1, U2.23
LCD_V3: C_V3.1, U2.24
LCD_V4: C_V4.1, U2.25
LCD_VOUT: C_VOUT.1, TP_VOUT.1, U2.32
SPARE_GP26: J_ADC.1, U1.GP26
SPARE_GP27: J_ADC.2, U1.GP27
SPARE_GP28: J_ADC.3, U1.GP28
SPARE_GP29: J_ADC.4, U1.GP29
SWCLK: J1.1, U1.SWCLK
SWDIO: J1.3, U1.SWDIO
VSYS_5V: JP_BL.1, TP_VSYS.1, U1.VSYS
VSYS_BL: JP_BL.2, R_BL1.1, R_BL2.1, R_BL3.1
