NormanStaub/naub/firmware/v2/host/naub_bridge.py

"""Drive the mixer screen from this PC's real audio.

    python naub_bridge.py [--port COMx] [--rate 50] [--wait S] [--seconds S]

`--rate 50` is an upper bound, not a promise: MEASURED at 31.5 Hz, because
Windows' default timer granularity is 15.6 ms and the loop's 2 ms sleep rounds
up to it, so a 20 ms period takes two of them.  It is left alone deliberately.
Reaching a true 50 Hz means timeBeginPeriod(1) and a loop spinning sixteen
times as often, which is more load on the user's PC to feed a meter that is
already smoothed by its own ballistics -- the opposite of the trade this file
is trying to make.
    python naub_bridge.py --ports          # what serial ports are there?
    python naub_bridge.py --sessions       # what audio does Windows see?
    python naub_bridge.py --once           # don't reconnect; exit on unplug

LEAVE THIS RUNNING.  Without it the device has no audio to show and no way to
apply a knob: the panel is a display, the host is the thing that talks to
WASAPI.  It reconnects by itself when the board reloads (every deploy.py does)
or is replugged, so it can just stay in a terminal.

Streams the live per-app WASAPI levels (appmeter.py) to the device over the USB
CDC *data* port, and applies knob moves coming back.  The device runs
demos/demo_mixer.py, which falls back to simulated levels when no host is
talking to it.

Requires device/boot.py deployed and the board POWER CYCLED once, so the data
port exists -- see that file.  Run `python naub_bridge.py --ports` to see what
was found.

Column assignments are OURS to keep.  The device is a display; it loses
everything on a reload, and a reload happens on every deploy.  So the pins live
in a file here (PIN_PATH) and are pushed back on every connect -- a column
assigned to an app keeps that app when the board reboots, when this bridge
restarts, and when the app itself is closed and later relaunched, at which
point the column simply starts controlling it again.

Which apps are OFFERED in the switcher is the device's business, not ours (see
device/wheel.py): we say what is streaming, it decides what is worth showing
and for how long.  That is deliberate -- the accounting is per-app timers at a
few hertz, and this is the user's PC.

Protocol (PROTOCOL.md; `meter` is the V2 addition):

    ->  label <ch> <text>     column name, ch 0-2
    ->  level <ch> <0..100>   volume; ch 3 is the system/master
    ->  mute  <ch> <0|1>
    ->  meter <v0> <v1> <v2>  column levels, sent at --rate Hz
    ->  apps  <A,B,C>         every app with a live session (the switcher list)
    ->  ameter <v0> <v1> ...  one level per app in that list; fast while the
                              switcher is open, 5 Hz otherwise
    ->  ping                  liveness probe; the device answers `pong`
    <-  vol   <ch> <0..100>   a knob moved
    <-  mute  <ch> <0|1>      a knob was held; ch 3 is the system knob's click
    <-  pick  <ch> <APP>      the switcher assigned an app to a column.  One
                              app, one column: if another column already holds
                              it, the two SWAP
    <-  mode  <idx>           the mode bar was flipped (BTN1/BTN2), and on
                              connect -- the spectrum capture only runs while
                              the screen that draws it is up
    <-  wheel <0|1>           the switcher opened / closed
    <-  btn   <n> <0|1>       an aux key; BTN3-5 are media transport and are
                              ALSO sent as USB HID, which is what actually
                              moves the track -- this line is only telemetry
"""
import json
import os
import re
import sys
import time

import serial
from serial.tools import list_ports

import appmeter
import eqapo
import sysmeter

NCOL = 3
SBANDS = 21               # must match device/eqscreen.NMETER
EQ_MODE = 1               # ... and demo_mixer.EQ_MODE
VID_PID = '2E8A'
RESCAN_S = 1.0            # how often to re-enumerate audio sessions
RECONNECT_S = 1.0         # how often to look for the board after it vanishes
AMETER_IDLE_S = 0.2       # switcher shut: the device only needs enough to time
                          # how long each app has been playing (device/wheel.py)

# Where the column assignments live.  Not in the repo and not next to the
# script: this is user state, and it has to survive a git checkout.
PIN_PATH = os.path.join(os.environ.get('LOCALAPPDATA')
                        or os.path.expanduser('~'), 'naub', 'pins.json')


def load_pins():
    """Column assignments from the last session.  Any failure means no pins,
    never a crash: this is a convenience file, and starting unpinned is a
    perfectly good state."""
    out = [None] * NCOL
    try:
        with open(PIN_PATH) as f:
            got = json.load(f).get('pinned') or []
    except Exception:
        return out
    for i in range(min(NCOL, len(got))):
        out[i] = got[i] or None
    return out


def save_pins(pinned):
    try:
        d = os.path.dirname(PIN_PATH)
        if not os.path.isdir(d):
            os.makedirs(d)
        with open(PIN_PATH, 'w') as f:
            json.dump({'pinned': pinned}, f)
    except Exception as e:
        print('could not save column pins (%s)' % e)


class Dropped(Exception):
    """The device went away -- a reload, a replug, or the port closing.

    This is the NORMAL case, not an error: every `deploy.py` reloads the board
    and drops the CDC link.  A bridge that died here would leave the panel
    showing nothing and silently stop applying knob moves, which looks exactly
    like a firmware bug and is not one."""


def _iface(p):
    """USB interface number behind a COM port, or 0 if it cannot be told.

    Windows reports this inconsistently.  On this board the console comes back
    with location=None and the data port with location='1-10.3:x.2' -- the
    trailing number is the interface.  Other setups tag the hwid with MI_00 /
    MI_02 instead, so try both.
    """
    m = re.search(r'MI_(\d+)', (p.hwid or '').upper())
    if m:
        return int(m.group(1))
    m = re.search(r'[:.](\d+)$', p.location or '')
    if m:
        return int(m.group(1))
    return 0


def find_ports():
    """-> (console, data) device names for the naub board.

    CircuitPython puts the REPL on the first CDC interface and the data port on
    the second, so the lowest interface number is the console and the highest
    is the data port.  Before boot.py takes effect there is only ONE port --
    which is how 'not power cycled yet' is detected.
    """
    cands = [p for p in list_ports.comports()
             if VID_PID in (p.hwid or '').upper()]
    if not cands:
        return None, None
    cands.sort(key=_iface)
    if len(cands) == 1:
        return cands[0].device, None
    return cands[0].device, cands[-1].device


def open_data(port):
    s = serial.Serial()
    s.port = port
    s.baudrate = 115200
    s.timeout = 0
    s.write_timeout = 0.5
    s.dtr = True
    s.open()
    return s


class Bridge:
    def __init__(self, ser, rate=50.0):
        self.ser = ser
        self.rate = rate
        self.src = appmeter.AppMeters()
        self.keys = []            # what each column shows
        self.apps = []            # every app with a live session
        self.pinned = load_pins()     # columns the device chose by hand
        self.wheel_open = False       # is the switcher up?  It meters faster
        self.vol = [None] * (NCOL + 1)
        self.muted = [None] * (NCOL + 1)   # ... + the system endpoint
        self.eq = eqapo.ParametricEq()
        # The EQ screen's meter is a REAL analysis of the system output, not an
        # invented shape: per-app spectrum does not exist, but the endpoint can
        # be captured.  Optional -- without it the screen just shows a floor.
        # Started ON DEMAND -- see want_spectrum().  It is a 48 kHz capture
        # thread on somebody's PC and only one screen ever looks at it.
        self.sys = sysmeter.SysMeter(nband=SBANDS)
        self.sys_ok = False
        self.mode = 0
        self._rx = b''
        if any(self.pinned):
            print('columns restored: %s'
                  % ' | '.join(p or '-' for p in self.pinned))

    def send(self, s):
        try:
            self.ser.write((s + '\n').encode('ascii', 'replace'))
        except serial.SerialTimeoutException:
            pass                      # device not draining; drop the line
        except (serial.SerialException, OSError):
            raise Dropped()

    def columns(self):
        """Which app each column shows.  A column the user assigned from the
        switcher stays put; the rest track the most active sessions.  Without
        the pinning, a hand-picked column would be overwritten the moment the
        busiest three changed."""
        auto = [k for k in self.src.top(NCOL * 2)
                if k and k not in self.pinned]
        out = []
        for i in range(NCOL):
            if self.pinned[i]:
                out.append(self.pinned[i])
            else:
                out.append(auto.pop(0) if auto else '')
        return out

    def want_spectrum(self, on):
        """Run the loopback capture only while the EQ screen is up.

        It is a thread reading 48 kHz audio and an open audio client on the
        user's machine, and exactly one of four modes draws it.  Starting it
        costs about as long as the mode wipe takes, so the screen has its
        spectrum by the time it finishes sliding in."""
        if on and not self.sys_ok:
            t0 = time.monotonic()
            self.sys_ok = self.sys.start()
            if self.sys_ok:
                print('  spectrum on (%s, %.0f ms)'
                      % (self.sys.name, (time.monotonic() - t0) * 1000))
            else:
                print('  spectrum unavailable: %s' % self.sys.error)
        elif not on and self.sys_ok:
            self.sys.stop()
            self.sys_ok = False
            print('  spectrum off')

    def push_apps(self, force=False):
        """The switcher's list: everything making noise, in full.  Sent as one
        comma-separated line because process names can contain spaces."""
        apps = self.src.active()
        if apps == self.apps and not force:
            return False
        self.apps = apps
        self.send('apps %s' % ','.join(k.upper() for k in apps))
        print('apps: %s' % (', '.join(apps) or '(none)'))
        return True

    def push_names(self, force=False):
        keys = self.columns()
        if keys == self.keys and not force:
            return False
        self.keys = keys
        for i, k in enumerate(keys):
            self.send('label %d %s' % (i, (k or '').upper()))
        print('columns: %s' % ' | '.join(k or '-' for k in keys))
        return True

    def push_state(self):
        """Keep the panel honest about volume/mute changed elsewhere."""
        for i, k in enumerate(self.keys):
            v = int(self.src.volume(k) * 100 + 0.5) if k else 0
            if v != self.vol[i]:
                self.vol[i] = v
                self.send('level %d %d' % (i, v))
            m = 1 if (k and self.src.muted(k)) else 0
            if m != self.muted[i]:
                self.muted[i] = m
                self.send('mute %d %d' % (i, m))
        v = int(self.src.system_volume() * 100 + 0.5)
        if v != self.vol[NCOL]:
            self.vol[NCOL] = v
            self.send('level %d %d' % (NCOL, v))
        m = 1 if self.src.system_muted() else 0
        if m != self.muted[NCOL]:
            self.muted[NCOL] = m
            self.send('mute %d %d' % (NCOL, m))

    def handle(self, line):
        t = line.split()
        if not t:
            return
        if t[0] == 'eqp' and len(t) == 4:
            i, param, val = int(t[1]), t[2], t[3]
            if 0 <= i < len(self.eq.bands):
                if param == 'kind':
                    self.eq.set_band(i, kind=val)
                elif param == 'on':
                    self.eq.set_band(i, on=val == '1')
                elif param == 'gain':
                    self.eq.set_band(i, db=float(val))
                elif param == 'freq':
                    self.eq.set_band(i, f0=float(val))
                elif param == 'q':
                    self.eq.set_band(i, q=float(val))
                print('  eq band %d %s -> %s' % (i, param, val))
        elif t[0] == 'eqflat':
            self.eq.flat()
            print('  eq flat')
        elif t[0] == 'mode' and len(t) == 2:
            # The spectrum is only captured, analysed and streamed for the one
            # screen that draws it -- see want_spectrum().
            self.mode = int(t[1])
            print('  mode -> %s' % t[1])
            self.want_spectrum(self.mode == EQ_MODE)
        elif t[0] == 'wheel' and len(t) == 2:
            self.wheel_open = t[1] == '1'
        elif t[0] == 'pong':
            print('  pong')
        elif t[0] == 'btn' and len(t) == 3:
            if t[2] == '1':
                print('  aux key %s' % t[1])
        elif t[0] == 'vol' and len(t) == 3:
            ch, v = int(t[1]), int(t[2])
            if ch == NCOL:
                self.src.set_system_volume(v / 100.0)
            elif 0 <= ch < len(self.keys) and self.keys[ch]:
                self.src.set_volume(self.keys[ch], v / 100.0)
            if ch <= NCOL:
                self.vol[ch] = v          # ours now; do not echo it back
            print('  knob %d -> %d%%' % (ch, v))
        elif t[0] == 'mute' and len(t) == 3:
            ch, m = int(t[1]), int(t[2])
            if ch == NCOL:                    # the system knob's click
                self.src.set_system_mute(bool(m))
            elif 0 <= ch < len(self.keys) and self.keys[ch]:
                self.src.set_mute(self.keys[ch], bool(m))
            self.muted[ch] = m            # ours now; do not push it back
            print('  mute %d -> %d' % (ch, m))
        elif t[0] == 'pick' and len(t) >= 3:
            ch = int(t[1])
            key = ' '.join(t[2:]).lower()
            if 0 <= ch < NCOL:
                # One app, one column.  Taking an app another column is
                # PINNED to swaps the two rather than showing it twice: two
                # columns driving one fader would fight, and whichever lost
                # would look broken.  What this column had goes where the app
                # came from, which is what "swap" means to the hand that did
                # it.
                #
                # Only pinned collisions.  A column that merely happens to be
                # showing the app on its own has nothing to swap -- pinning it
                # here removes the app from the auto pool, so that column
                # picks the next busiest by itself, and forcing OUR app onto it
                # would be pinning a column the user never chose.
                prev = self.pinned[ch] or (self.keys[ch]
                                           if ch < len(self.keys) else '')
                for j in range(NCOL):
                    if j != ch and self.pinned[j] == key:
                        self.pinned[j] = prev or None
                        print('  column %d takes %s' % (j, prev or '(auto)'))
                self.pinned[ch] = key
                save_pins(self.pinned)
                print('  column %d pinned to %s' % (ch, key))
                self.push_names(force=True)
                self.push_state()
        elif t[0] == 'naub':
            print('  device: %s' % line)
            self.push_apps(force=True)
            self.push_names(force=True)
            self.push_state()

    def poll_rx(self):
        try:
            n = self.ser.in_waiting
            if not n:
                return
            self._rx += self.ser.read(n)
        except (serial.SerialException, OSError):
            raise Dropped()
        if b'\n' not in self._rx:
            return
        parts = self._rx.split(b'\n')
        self._rx = parts.pop()                # keep the trailing partial line
        for raw in parts:
            self.handle(raw.decode('utf-8', 'replace').strip())

    def push_eq(self):
        """Everything the EQ screen needs: what the engine can do, whether it
        would be heard at all, and where every band currently sits."""
        ok, why = self.eq.status()
        self.send('eqcaps %d %g %g %g %d %d'
                  % (len(self.eq.bands), eqapo.FMIN, eqapo.FMAX, eqapo.MAXDB,
                     48000, 1 if ok else 0))
        for i, b in enumerate(self.eq.bands):
            self.send('eqband %d %s' % (i, b.wire()))
        print('eq: %s -- %s' % ('ready' if ok else 'INERT', why))

    def resync(self):
        """Push everything the device needs after a (re)connect.  It boots with
        nothing and is not the source of truth for volume -- see PROTOCOL.md
        section 3."""
        self.keys = []
        self.apps = []
        self.vol = [None] * (NCOL + 1)
        self.muted = [None] * (NCOL + 1)
        self.send('hello')
        self.push_apps(force=True)
        self.push_names(force=True)
        self.push_state()
        self.push_eq()

    def run(self, seconds=0.0):
        """Stream until --seconds elapses, or forever.  Raises Dropped when the
        device goes away, which the caller turns into a reconnect."""
        period = 1.0 / self.rate
        t0 = time.monotonic()
        next_meter = t0
        next_ameter = t0
        next_scan = t0 + RESCAN_S
        next_log = t0 + 1.0
        sent = 0
        while True:
            now = time.monotonic()
            if seconds and now - t0 >= seconds:
                print('ran %.1fs, sent %d meter frames' % (now - t0, sent))
                return
            self.poll_rx()
            if now >= next_meter:
                next_meter = now + period
                lv = self.src.levels(self.keys)
                self.send('meter %d %d %d' % tuple(
                    int(min(1.0, x) * 100 + 0.5) for x in lv))
                # Full rate while the switcher is up, because its bar has
                # ballistics; a fifth of a second otherwise, which is all the
                # device needs to tell a track from a notification chime.
                # This is a peak poll per app per send, so it is real work.
                if self.apps and (self.wheel_open or now >= next_ameter):
                    next_ameter = now + AMETER_IDLE_S
                    self.send('ameter %s' % ' '.join(
                        '%d' % int(min(1.0, x) * 100 + 0.5)
                        for x in self.src.levels(self.apps)))
                if self.sys_ok and self.mode == EQ_MODE:
                    self.send('smeter %s' % ' '.join(
                        '%d' % int(v * 100 + 0.5) for v in self.sys.bands()))
                sent += 1
                if now >= next_log:
                    next_log = now + 1.0
                    print('  %s' % '  '.join(
                        '%-10s %3d%% %s' % (k or '-', int(v * 100),
                                            '#' * int(v * 18))
                        for k, v in zip(self.keys, lv)))
            # Debounced: a knob per detent would otherwise make Equalizer
            # APO re-parse the user's whole config a hundred times a second.
            self.eq.tick(now)
            if now >= next_scan:
                next_scan = now + RESCAN_S
                # WASAPI can be mid-change here (see AppMeters.refresh); ride
                # it out rather than dying, because the panel going dark is a
                # far worse outcome than a second of stale levels.
                try:
                    if self.src.refresh():
                        self.push_apps()
                        self.push_names()
                        self.push_state()
                        if self.sys_ok:
                            self.sys.restart_if_dead()
                except Dropped:
                    raise
                except Exception as e:
                    print('audio rescan failed (%s); retrying' % e)
            time.sleep(0.002)


def _is_bridge(pid):
    """A running bridge shows up here (not in its OWN list -- it skips itself)
    because its loopback capture opens the render endpoint.  Say so, rather
    than leave a mystery `python` playing whatever you are listening to."""
    try:
        import psutil
        return 'naub_bridge' in ' '.join(psutil.Process(pid).cmdline())
    except Exception:
        return False


def show_sessions():
    """Every audio session Windows has, grouped the way a column groups them.

    Here because "that app is in the list but has no level and the knob does
    nothing" is a question about WASAPI, not about the panel, and the answer is
    usually that the program holds more than one session and only one of them
    is the one you can hear."""
    src = appmeter.AppMeters()
    groups = src.sessions()
    if not groups:
        print('no audio sessions (%s)' % (src._fail or 'nothing is playing'))
        return
    print('%-16s %-4s %s' % ('program', 'n', 'sessions (pid, state, peak, fader)'))
    for key in sorted(groups):
        g = groups[key]
        bits = ['%d %s peak=%.3f vol=%.2f%s'
                % (x.pid, 'ACTIVE' if x.active else 'idle  ',
                   max(x.peak() for _ in range(4)), x.gain(),
                   '  <- a naub bridge capturing the output' if _is_bridge(x.pid)
                   else '')
                for x in g]
        print('%-16s %-4d %s' % (key, len(g), ' | '.join(bits)))
    print()
    print('offered to the switcher: %s' % (', '.join(src.active()) or '(none)'))
    print('columns would be       : %s' % ' | '.join(k or '-' for k in src.top(NCOL)))


def serve(port, rate, seconds):
    """One connected session.  -> True if it ended on its own terms."""
    ser = open_data(port)
    try:
        b = Bridge(ser, rate)
        b.resync()
        b.run(seconds)
        return True
    finally:
        try:
            ser.close()
        except Exception:
            pass


def wait_for_data(timeout):
    """Block until the data port shows up (i.e. the board was power cycled)."""
    end = time.monotonic() + timeout
    seen = None
    while time.monotonic() < end:
        cons, data = find_ports()
        if data:
            return data
        if cons != seen:
            seen = cons
            print('  waiting for the data port; console on %s' % cons)
        time.sleep(0.5)
    return None


def main(argv):
    # This is usually left running in a terminal or piped to a log, and a
    # block-buffered log that says nothing for 4 kB is useless for telling
    # whether the link is alive.
    try:
        sys.stdout.reconfigure(line_buffering=True)
    except Exception:
        pass
    port = None
    rate = 50.0
    seconds = 0.0
    wait = 0.0
    once = False
    it = iter(argv)
    for a in it:
        if a == '--once':
            once = True
        elif a == '--port':
            port = next(it)
        elif a == '--rate':
            rate = float(next(it))
        elif a == '--seconds':
            seconds = float(next(it))
        elif a == '--wait':
            wait = float(next(it))
        elif a == '--sessions':
            show_sessions()
            return
        elif a == '--ports':
            for p in list_ports.comports():
                print('%-8s %s [%s]' % (p.device, p.description, p.hwid))
            print('\ndetected (console, data) = %r' % (find_ports(),))
            return
        else:
            sys.exit(__doc__)

    fixed_port = port
    if port is None:
        cons, port = find_ports()
        if port is None and wait:
            print('waiting up to %gs for a power cycle...' % wait)
            port = wait_for_data(wait)
        if port is None:
            sys.exit('No data port found.\n'
                     'Deploy device/boot.py and FULLY POWER CYCLE the board '
                     '(unplug/replug) so USB re-enumerates with two CDC '
                     'interfaces.\nConsole port seen: %s\n'
                     'Run with --ports to list what is there.' % cons)
    print('data port: %s at %g Hz%s'
          % (port, rate, '' if once else '  (reconnects on reload)'))
    fixed = fixed_port
    try:
        while True:
            try:
                serve(port, rate, seconds)
                return                      # --seconds elapsed: done
            except Dropped:
                print('device dropped (reload or replug) - waiting for it')
            except (serial.SerialException, OSError) as e:
                print('port error: %s - waiting for it' % e)
            if once:
                return
            # A reload re-enumerates, so re-find the port rather than trusting
            # the old name; only an explicit --port stays pinned.
            while True:
                time.sleep(RECONNECT_S)
                _, found = find_ports()
                port = fixed if fixed else found
                if port and (found or fixed):
                    break
            # Deliberately not announcing a reconnect here: the port merely
            # reappeared in the enumeration, and opening it can still fail.
            # serve() saying nothing and then streaming is the real signal.
    except KeyboardInterrupt:
        print('\nstopped')


if __name__ == '__main__':
    main(sys.argv[1:])
