NormanStaub/naub/firmware/v2/host/preview_fonts.py

"""What else could ccfont.TINY be?  Render candidate faces at the panel's scale.

    python preview_fonts.py [--size 11] [--sample "APP CTRL"]

The constraint is unforgiving: the whole glyph box must fit ONE 8px page, which
is what lets gfx.text_strip() emit page-aligned column bytes and makes the
mixer's marquee a byte-slice copy.  Inside that, caps get about 6 rows.  Almost
every "nice" typeface turns to mush when a 6px cap height is thresholded to
1-bit -- what survives is faces drawn for small sizes (strong hinting, few
diagonals, no thin strokes) and pixel/bitmap faces.

Each candidate is rasterized the way gen_font.py does it (size, then cropped to
8 rows from a ytop), measured on the strings the UI actually draws, and stamped
with whether it fits the two places that matter:

    * a mixer column name -- 40 px
    * a mode bar label    -- the widest is CUSTOM 2

Writes host/fonts_preview.png, one row per candidate at 4x.
"""
import _paths
import os
import sys

from PIL import Image, ImageDraw, ImageFont

import gen_font
import gfx

HERE = os.path.dirname(os.path.abspath(__file__))
WIN = os.path.join(os.environ.get('WINDIR', r'C:\Windows'), 'Fonts')
SRC = os.path.join(HERE, 'font_src')

# Candidates are the generator's own table, so the survey can never disagree
# with what `gen_font.py --face X` would actually produce, plus a few faces
# worth looking at that are not offered as a --face.
EXTRA = [
    ('Verdana', 'verdana.ttf', 9, 1),
    ('Segoe UI', 'segoeui.ttf', 9, 2),
    ('Arial', 'arial.ttf', 9, 1),
    ('Arial Narrow', 'arialn.ttf', 10, 1),
    ('Courier New', 'cour.ttf', 10, 2),
    ('Impact', 'impact.ttf', 9, 1),
]
CANDIDATES = [('%s (--face %s)' % (k, k), v[0], v[1], v[2], v[3])
              for k, v in sorted(gen_font.FACES.items())]
CANDIDATES += [(n, 'ttf', os.path.join(WIN, fn), sz, yt)
               for n, fn, sz, yt in EXTRA]

SAMPLES = ('APP CTRL', 'SPOTIFY', 'CHROME')
MEASURE = ('SPOTIFY', 'CUSTOM 2')   # the two fits that matter
H = 8                       # one page: the hard constraint
SCALE = 4
COL_W = 40                  # a mixer column's usable width


def render_any(kind, src, size, ytop, text):
    """Raster faces go through GDI, outlines through PIL.  Without this the
    survey silently omits every bitmap font -- which is most of what is worth
    looking at down here."""
    if kind == 'gdi':
        import gdifont
        w, rows = gdifont.render(src, size, text)
        out = []
        for y in range(H):
            sy = y + ytop
            out.append(list(rows[sy]) if sy < len(rows) else [False] * w)
        return w, out
    return render(src, size, ytop, text)


def render(path, size, ytop, text):
    """-> (width, list of 8 rows of bools), cropped exactly like gen_font."""
    f = ImageFont.truetype(path, size)
    asc, desc = f.getmetrics()
    src_h = asc + desc
    # Draw at an offset and keep whatever the face drew: proportional faces
    # overhang their advance and can start left of the pen origin, and clipping
    # either shears the glyph -- the survey would then be judging the bug.
    adv = max(int(round(f.getlength(text))), 1)
    ox = 4
    im = Image.new('1', (adv + 2 * ox + 8, src_h + ytop + 4), 0)
    ImageDraw.Draw(im).text((ox, 0), text, font=f, fill=1)
    px = im.load()
    cols = [x for x in range(im.width)
            if any(px[x, y] for y in range(im.height))]
    start = min(ox, cols[0]) if cols else ox
    w = max(adv + (ox - start), (cols[-1] - start + 1) if cols else 0, 1)
    rows = []
    for y in range(H):
        sy = y + ytop
        rows.append([bool(px[start + x, sy])
                     if sy < im.height and start + x < im.width else False
                     for x in range(w)])
    return w, rows


def ink_rows(rows):
    """Which of the 8 rows carry ink -- i.e. does the face actually fit?"""
    used = [i for i, r in enumerate(rows) if any(r)]
    return (used[0], used[-1]) if used else (0, 0)


def main(argv):
    out_rows = []
    for label, kind, src, size, ytop in CANDIDATES:
        if kind == 'ttf' and not os.path.exists(src):
            print('  -- %-22s MISSING (%s)' % (label, os.path.basename(src)))
            continue
        try:
            widths = {}
            strips = []
            top = 8
            bot = 0
            for s in SAMPLES:
                w, rows = render_any(kind, src, size, ytop, s)
                widths[s] = w
                a, b = ink_rows(rows)
                top = min(top, a)
                bot = max(bot, b)
                strips.append((s, w, rows))
            for s in MEASURE:               # measured, not drawn
                widths[s] = render_any(kind, src, size, ytop, s)[0]
        except Exception as e:
            print('  -- %-22s FAILED (%s)' % (label, e))
            continue
        fits_col = widths['SPOTIFY'] <= COL_W
        fits_bar = widths['CUSTOM 2'] <= 60
        print('  %-22s rows %d..%d  SPOTIFY %2dpx %s  CUSTOM 2 %2dpx %s'
              % (label, top, bot, widths['SPOTIFY'],
                 'fits' if fits_col else 'WIDE', widths['CUSTOM 2'],
                 'fits' if fits_bar else 'WIDE'))
        out_rows.append((label, strips))

    if not out_rows:
        sys.exit('no candidates rendered')

    pad = 2
    line_h = (H + pad) * SCALE
    label_w = 150
    width = label_w + gfx.W * SCALE
    canvas = Image.new('L', (width, line_h * len(out_rows) + 8), 255)
    d = ImageDraw.Draw(canvas)
    for i, (label, strips) in enumerate(out_rows):
        y0 = i * line_h + 4
        d.text((4, y0 + 4), label, fill=0)
        px = 0                              # cursor in DISPLAY pixels, not canvas
        for s, w, rows in strips:
            for ry, row in enumerate(rows):
                for rx, on in enumerate(row):
                    if not on or px + rx >= gfx.W:
                        continue
                    cx = label_w + (px + rx) * SCALE
                    cy = y0 + ry * SCALE
                    d.rectangle([(cx, cy), (cx + SCALE - 1, cy + SCALE - 1)],
                                fill=0)
            px += w + 6
    path = os.path.join(HERE, 'fonts_preview.png')
    canvas.save(path)
    print('wrote %s (%d candidates)' % (path, len(out_rows)))


if __name__ == '__main__':
    main(sys.argv[1:])
