NormanStaub/naub/firmware/v2/host/gen_switcher.py

"""Regenerate demos/switcher_data.py: every open app's icon, FRC-encoded once
per drawer size tier.

    python gen_switcher.py [--apps 8] [--png a.png b.png ...]
    python deploy.py mixer

Unlike gen_appicons.py (which bakes one fixed screen), this emits *movable*
blocks: each icon is encoded at ox=0 on its tier's page row and stored as
`size` bytes per page.  drawer.py then blits a block to any column with a
byte-slice copy, which is what makes the scroll animation affordable on-device.

The dither pattern is baked at x=0, so an icon drawn at a column that is not a
multiple of 4 gets its Bayer phase shifted.  That is invisible (it is noise
either way) and it buys per-pixel-free positioning.

This is only the starting set now, for when no host has sent anything better:
naubd makes an icon for whatever is playing and pushes it (naubd/src/appicon.rs),
and gen_frc_golden.py holds its encoder to this one.
"""
import _paths
import os, sys, tempfile
from PIL import Image
import appscan, gfx, frc, drawer

MAX_APPS = 8            # keep the emitted module small enough to parse on-device


def block(im, size, page0, n=4):
    """PIL image -> tuple of `n` page-aligned blocks (size bytes per page).

    page0 is the drawer-panel-local page; the Bayer phase is taken at the
    SCREEN row the block will land on, so the dither lines up with anything
    else encoded on the same rows."""
    pages = size >> 3
    fbs = frc.encode_image(im, n=n, size=(size, size), ox=0,
                           oy=(drawer.PANEL_P0 + page0) * 8)
    out = []
    for fb in fbs:
        b = bytearray(pages * size)
        for r in range(pages):
            o = (drawer.PANEL_P0 + page0 + r) * gfx.W
            b[r * size:(r + 1) * size] = fb[o:o + size]
        out.append(bytes(b))
    return tuple(out)


def encode_app(png, n=4):
    im = Image.open(png)
    return tuple(block(im, size, page0, n) for size, page0 in drawer.TIERS)


def emit(path, names, icons):
    # ascii only: bytes reprs are escaped, and CircuitPython reads plain ascii
    with open(path, 'w', encoding='ascii') as f:
        f.write('"""App icons for the app-switcher drawer, FRC-encoded per size '
                'tier.\n\nICONS[app][tier][plane] -> page-aligned block, tiers '
                'matching drawer.TIERS %r.\nGenerated by '
                'host/gen_switcher.py - do not edit.\n"""\n' % (drawer.TIERS,))
        f.write('APPS = (\n')
        for nm in names:
            f.write('    %s,\n' % ascii(nm))     # escapes any non-ascii name
        f.write(')\n\nICONS = (\n')
        for app in icons:
            f.write('  (\n')
            for tier in app:
                f.write('    (\n')
                for plane in tier:
                    f.write('      %r,\n' % plane)
                f.write('    ),\n')
            f.write('  ),\n')
        f.write(')\n')


def main(argv):
    here = os.path.dirname(os.path.abspath(__file__))
    limit = MAX_APPS
    pngs = []
    it = iter(argv)
    for a in it:
        if a == '--apps':
            limit = int(next(it))
        elif a == '--png':
            pngs = list(it)
        else:
            sys.exit(__doc__)

    if pngs:
        apps = [(os.path.splitext(os.path.basename(p))[0], p) for p in pngs]
    else:
        td = tempfile.mkdtemp()
        apps = appscan.open_app_icons(td)
        if not apps:
            sys.exit('no app icons found')
    apps = apps[:limit]

    names = tuple(n.upper() for n, _ in apps)
    icons = [encode_app(p) for _, p in apps]
    out = os.path.normpath(os.path.join(here, '..', 'demos', 'switcher_data.py'))
    emit(out, names, icons)
    print('wrote %s: %d apps, tiers %r, %d bytes of icon data (%.0f kB module)'
          % (out, len(apps), drawer.TIERS,
             sum(len(p) for a in icons for t in a for p in t),
             os.path.getsize(out) / 1024.0))


if __name__ == '__main__':
    main(sys.argv[1:])
