NormanStaub/naub/firmware/v2/host/deploy.py

"""Deploy a demo (or your own code.py) to the naub V2 CIRCUITPY drive.

    python deploy.py ball|gray|icons|mixer [--drive K:] [--port COM9] [--no-watch]
    python deploy.py path\\to\\my_code.py

Order matters: support modules first, code.py LAST — every copy triggers a
CircuitPython auto-reload and only the final one should run.  Serial is
strictly READ-ONLY: host->device console writes hang on this board (bring-up
finding), so we only listen for the boot banner / tracebacks.
"""
import os, re, shutil, sys, time

HERE = os.path.dirname(os.path.abspath(__file__))
DEVICE = os.path.normpath(os.path.join(HERE, '..', 'device'))
DEMOS = os.path.normpath(os.path.join(HERE, '..', 'demos'))

# boot.py first: it only takes effect after a power cycle, and copying it is
# harmless for the demos that do not use the data port.
LIBS = ('boot.py', 'gfx.py', 'ballistics.py', 'ccfont.py', 'st7565.py',
        'naubhw.py', 'link.py',
        'mixer.py', 'drawer.py', 'media.py', 'eqcurve.py', 'eqscreen.py',
        'wipe.py', 'idle.py', 'wheel.py', 'qrdata.py', 'config.py')
# Data modules a LIB needs, shipped whatever is being deployed: drawer.py
# imports nothing itself, but every user of it needs the icon blocks, and the
# blocks have to match drawer.TIERS.  Deploying a one-off script without these
# left the board running new code against stale icon data.
DATA = ('switcher_data.py',)
DEMO_MAP = {
    'ball':   ('demo_ball.py', ()),
    'gray':   ('demo_gray_modes.py', ('graybars.py', 'graygrad.py')),
    'icons':  ('demo_app_icons.py', ('appicons.py',)),
    'mixer':  ('demo_mixer.py', ('switcher_data.py',)),
}


def watch(port, seconds=5.0):
    try:
        import serial
    except ImportError:
        print('(pyserial not installed - skipping console watch)')
        return
    s = serial.Serial()
    s.port = port
    s.baudrate = 115200
    s.timeout = 0.2
    s.dtr = True
    s.rts = True
    try:
        s.open()
    except Exception as e:
        print('(serial %s unavailable: %s)' % (port, e))
        return
    buf = b''
    end = time.time() + seconds
    while time.time() < end:
        buf += s.read(4096)
    s.close()
    txt = buf.decode('utf-8', 'replace')
    txt = re.sub(r'\x1b\][^\x1b]*\x1b\\', '', txt)          # OSC titles
    txt = re.sub(r'\x1b\[[0-9;]*[A-Za-z]', '', txt)         # CSI
    # The Windows console is cp1252 by default and serial line noise is not:
    # printing a stray byte would raise UnicodeEncodeError and lose the whole
    # capture, which is the one thing this function exists to show.
    txt = txt.encode('ascii', 'replace').decode('ascii')
    print('----- console (%ss) -----' % seconds)
    print(txt.strip() or '(no output)')
    print('----- end -----')


def main(argv):
    drive = 'K:'
    port = 'COM9'
    do_watch = True
    args = []
    it = iter(argv)
    for a in it:
        if a == '--drive':
            drive = next(it)
        elif a == '--port':
            port = next(it)
        elif a == '--no-watch':
            do_watch = False
        else:
            args.append(a)
    if len(args) != 1:
        sys.exit(__doc__)

    if args[0] in DEMO_MAP:
        code, extras = DEMO_MAP[args[0]]
        code = os.path.join(DEMOS, code)
        extras = [os.path.join(DEMOS, e) for e in extras]
    else:
        code = args[0]
        extras = []
        if not os.path.exists(code):
            sys.exit('no such demo or file: %s' % args[0])

    root = drive if drive.endswith('\\') else drive + '\\'
    for lib in LIBS:
        shutil.copy(os.path.join(DEVICE, lib), root + lib)
        print('-> %s%s' % (root, lib))
    for e in extras:
        shutil.copy(e, root + os.path.basename(e))
        print('-> %s%s' % (root, os.path.basename(e)))
    for d in DATA:
        if os.path.basename(d) not in [os.path.basename(e) for e in extras]:
            shutil.copy(os.path.join(DEMOS, d), root + d)
            print('-> %s%s' % (root, d))
    shutil.copy(code, root + 'code.py')
    print('-> %scode.py  (%s)' % (root, os.path.basename(code)))
    if do_watch:
        watch(port)


if __name__ == '__main__':
    main(sys.argv[1:])
