NormanStaub/naub/naubd/src/dsp.rs

//! The sample-level work of the macOS engine, free of Core Audio.
//!
//! Everything here runs inside a real-time IOProc on the Mac: no allocation, no
//! locks, no logging, and nothing that can panic on a well-formed buffer. It is
//! a separate module, compiled on every target under `cfg(test)`, so the part
//! of the port that decides what you hear can be tested on any machine.
//!
//! Filters are the same RBJ cookbook biquads as `device/eqcurve.coeffs`, which
//! is also what Equalizer APO implements, so the curve the panel draws is the
//! curve that gets applied.

#![cfg_attr(not(target_os = "macos"), allow(dead_code))]

use std::sync::atomic::{AtomicU32, AtomicUsize, Ordering};

pub const NBAND: usize = 3;
/// Smoothing on a knob move, so a detent is not a click.
pub const RAMP_S: f32 = 0.030;
/// How fast a held peak falls between reads. The bridge polls at its own rate
/// and more than one reader looks at the same app, so a read must not reset it.
pub const PEAK_TAU_S: f32 = 0.060;
/// A band closer to flat than this is not worth running audio through us for.
const FLAT_DB: f32 = 0.01;

#[derive(Clone, Copy, Debug, Default, PartialEq)]
pub struct Coeffs {
    pub b0: f64,
    pub b1: f64,
    pub b2: f64,
    pub a1: f64,
    pub a2: f64,
}

pub const KIND_PK: u32 = 0;
pub const KIND_LSC: u32 = 1;
pub const KIND_HSC: u32 = 2;

pub fn kind_code(kind: &str) -> u32 {
    match kind {
        "LSC" => KIND_LSC,
        "HSC" => KIND_HSC,
        _ => KIND_PK,
    }
}

/// `device/eqcurve.coeffs`, line for line, its Nyquist clamp included.
#[allow(clippy::approx_constant)]
pub fn coeffs(kind: u32, f0: f64, db: f64, q: f64, rate: f64) -> Coeffs {
    let a = 10f64.powf(db / 40.0);
    let w0 = (2.0 * std::f64::consts::PI * f0 / rate).min(3.14159);
    let (cw, sw) = (w0.cos(), w0.sin());
    let alpha = sw / (2.0 * q.max(0.01));
    let (b0, b1, b2, a0, a1, a2);
    if kind == KIND_PK {
        b0 = 1.0 + alpha * a;
        b1 = -2.0 * cw;
        b2 = 1.0 - alpha * a;
        a0 = 1.0 + alpha / a;
        a1 = -2.0 * cw;
        a2 = 1.0 - alpha / a;
    } else {
        let sa = 2.0 * a.sqrt() * alpha;
        let (ap1, am1) = (a + 1.0, a - 1.0);
        if kind == KIND_LSC {
            b0 = a * (ap1 - am1 * cw + sa);
            b1 = 2.0 * a * (am1 - ap1 * cw);
            b2 = a * (ap1 - am1 * cw - sa);
            a0 = ap1 + am1 * cw + sa;
            a1 = -2.0 * (am1 + ap1 * cw);
            a2 = ap1 + am1 * cw - sa;
        } else {
            b0 = a * (ap1 + am1 * cw + sa);
            b1 = -2.0 * a * (am1 + ap1 * cw);
            b2 = a * (ap1 + am1 * cw - sa);
            a0 = ap1 - am1 * cw + sa;
            a1 = 2.0 * (am1 - ap1 * cw);
            a2 = ap1 - am1 * cw - sa;
        }
    }
    Coeffs { b0: b0 / a0, b1: b1 / a0, b2: b2 / a0, a1: a1 / a0, a2: a2 / a0 }
}
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
