NormanStaub/naub/(commit log)

2026-06-11 Initial commit: naub project docs
    V1 hardware build outline, BOM, and wiring/pinout spec for the
    USB application/system audio mixer (Raspberry Pi Pico 2 based).
2026-06-13 Add encoder-bar e-paper bring-up example
    CircuitPython example for the V1 prototype: rotary encoder drives a 0-100
    bar + numeric readout on the 2.9" SSD1680 e-paper via a hand-written driver
    with windowed partial refresh.
    Includes README documenting wiring, install, and the partial-refresh
    performance findings (clean partial ~498ms floor; incremental draw win;
    custom fast waveforms cause whole-screen artifacts and aren't worth it).
2026-06-13 Document partial-refresh latency floor in e-paper example
    Records the measured findings: 0xFC is the panel's on-chip fast-partial
    waveform (~0.49s @ room temp vs 0.3s spec @25C - temperature-bound), and
    the lean 0xCC repeated-partial command saves only ~8ms (refresh is pure
    waveform time). Notes update-on-settle as the e-paper-native UX.
2026-06-16 Add dual-encoder bars + press-blob example
    Two rotary encoders as independent 0-100 e-paper bars, each with a press
    indicator (filled blob above the bar) driven by the encoder's push switch.
    Demonstrates multi-region windowed partial refresh (two bars + two blobs in
    one gate-line window; static text untouched). Validated on hardware:
    encoders 1 & 2 rotation + switch.
2026-06-17 Add dithered-preview value-rendering example
    Two encoders with live numeric readout + a dithered "preview" of the pending
    change (original level stays solid, change shows as sparse gray dots, commits
    to solid on settle). Plus encoder press-blobs, a Button 1 latching toggle, and
    idle-deferred ghost-sweep cleanup so the full refresh never flashes mid-use.
    Tuned around e-paper's ~0.5s refresh for responsiveness.
2026-06-17 Add developer handoff writeup
    Add WRITEUP.md capturing project state, non-documented decisions,
    gotchas, and roadmap for transferring development to another machine:
    - e-ink as a firm decision and the ~0.5s partial-refresh floor
    - panel survey (no faster 2.9" SPI part helps partial latency)
    - interface-board swap dead end (SSD1680 is COG-on-ribbon)
    - final-PCB MCU call (stay RP2350; module-down vs chip-down; E9 erratum)
    - known issues (Button 1 bring-up miswire, unsourced aux buttons)
    Link it from the README docs table.
2026-06-18 Add V1 firmware + host helper: per-app mixer over USB CDC with program icons
    Implements the deej-style per-app volume path end to end, validated on real
    hardware (Pico 2 / CircuitPython 10.2.1, encoders 1-2 + button 1 + e-paper).
    - PROTOCOL.md: proto=1 spec. Tagged, bidirectional line protocol over the CDC
    data port. Device->host vol/mute/btn events; host->device label/icon/level/
    mute. Icons are Base64-packed 1-bpp bitmaps (32x32) drawn on the e-paper.
    - firmware/: CircuitPython (boot.py enables the data CDC; code.py builds on the
    dithered_preview SSD1680 driver). 4-column panel with icon, label, level bar,
    number, and a mute strike. Relative (delta) encoder reads so host level
    p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
2026-06-18 Add hold-to-cycle source switching; fix realtime audio + icon rendering
    Source switching (hold-and-turn):
    - Firmware reads the encoder switch as a held state: hold + turn emits a new
    `cycle <ch> <dir>` event (one per detent, volume suppressed); a click
    (press+release, no turn) still toggles mute, disambiguated on release.
    - Host rebinds the channel to the next active app, skipping sources already
    bound to another knob (unique per knob); System stays pinned to its channel.
    Reconcile is now binding-keyed so a manual cycle sticks instead of snapping
    back to the config default.
    Realtime audio:
    - The ~0.5s e-paper refresh was a blocking wait that stalled vol events
    (~2/sec during a s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
    [app.py, code.py, icons_windows.py]
2026-06-19 Grayscale icons, commit-on-stop bars, full 4-encoder + flipped panel
    Icons: dither to grayscale via full-range Floyd-Steinberg (host-side; wire
    stays 1-bpp), chosen after comparing against an ordered/clamped-density
    palette live on the real 32x32 panel.
    Display/UX: bar commits only after the knob stops (SETTLE_S=0.13) with no
    live scrolling preview and no numeric overlay; audio still moves per detent.
    Hardware: rotate the panel 180deg for the case (both px() mirror flags),
    enable encoders 3 & 4 (GP14/15/16, GP17/18/19), and disable the now-unwired
    Button 1 (GP6) so a floating pin can't emit phantom events.
    [code.py, icons_windows.py]
2026-06-20 Filter source list to real audio apps; persist sticky channel selections
    Cycle pool: offer only apps that have produced audio this session (paused/idle
    media stays selectable; a sub-second UI ding isn't sampled by the ~2s poll),
    and drop the Windows system-sounds session. Keeps File Explorer / CAD and other
    silent-session apps out of the hold-to-cycle list.
    Sticky selections: once a channel is bound it stays on the panel (name + icon
    from the cached exe path + bar) through pause, app close, and device disconnect
    until manually cycled away. Selections persist to naub_state.json beside the
    config and reload on startup, so the same sources survive a reboot; config
    `match` is now just the initi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
    [app.py, audio_windows.py, config.py]
2026-06-20 Add naubd: native Rust port of the host (console daemon, parity)
    A from-scratch Windows daemon in Rust, replacing the Python host with a
    low-footprint native service (~14MB RSS vs ~35MB). Reaches full parity with
    the Python host on real hardware.
    - protocol.rs: proto=1 encode/decode (+ unit tests)
    - link.rs: USB CDC serial with VID/PID autodetect -- probes only known-VID USB
    ports, so Bluetooth/PCI ports are never opened (no COM-probe hang)
    - audio.rs: WASAPI via windows-rs COM -- per-app ISimpleAudioVolume, system
    IAudioEndpointVolume, session-state + system-sounds filtering, exe paths
    - icons.rs: ExtractIconEx + GDI -> grayscale -> Floyd-Steinberg -> 1-bpp pack
    - app.rs / config.rs /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
2026-06-20 naubd: tray icon, autostart, windowless background app
    Wrap the daemon as a real background app:
    - Release builds are windowless (windows_subsystem); debug keeps a console.
    - System-tray icon with a right-click menu: "Start with Windows" (toggles the
    HKCU Run key) and "Quit". Daemon runs on a worker thread; the main thread
    pumps the Win32 message loop.
    - File logging (naubd.log) so the windowless app keeps a record; also stdout in
    debug builds.
    - Config discovery now includes %APPDATA%\naub\config.json so autostart works
    when launched at login (cwd = system32).
    - CLI: --console / --config (foreground), --install / --uninstall (autostart).
    ~325 KB exe, ~15 MB RAM. README documents bu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
2026-06-21 Redesign panel UI (arc gauges + labels); fix icon delivery + state path
    Firmware UI: replace the bar/label layout with a per-app radial arc gauge
    (borderless filled stroke) wrapping a centered app icon, the app name
    underneath, and a vertical capsule for the system/master channel squashed to
    the right edge. Muted channels dither the arc fill (icon stays solid).
    Firmware reliability: scaling icons up to 40px exposed a USB-CDC RX overrun --
    a channel redraw blocked reads long enough for the ~300 B icon line to arrive
    truncated, then draw_icon_center indexed past the short data and crash-rebooted
    every reconnect. Fix: defer redraws until the receive burst goes quiet, reject
    under-length icon f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
    [code.py]
2026-06-29 Add V2 PCB design docs + SKiDL netlist
    - PCB_DESIGN.md: electrical reference — validated RP2350 pin map, debounce
    RC, backlight resistor/PWM (VBUS), 9-cap ST7565 charge-pump network,
    current budget, passives summary.
    - BOM_V2.md, PCB_NOTES.md: V2 parts delta + mechanical/build decisions.
    - pcb/naub_v2.py: circuit as SKiDL → KiCad netlist (41 parts, 45 nets,
    matches the pin map). Generated artifacts gitignored.
    Open item carried forward: confirm ST7565 CAP3 far-end (VOUT vs VSS)
    against the EA DOGM128-6 application schematic before fab.
2026-07-18 Add proto=2 EQ overlay: global tone control via Equalizer APO
    Introduces an EQ menu on the device (low/mid/high graph over the three
    app encoders) and a host-side global tone engine. New protocol verbs
    `eq`/`eqset` (D->H / H->D, mirroring vol/level) are additive and
    backward-compatible with proto=1 peers. On Windows the host applies
    bands through Equalizer APO via a hot-reloaded include file; the engine
    is optional (menu still opens if APO is absent).
2026-07-18 Rework V2 PCB for Waveshare RP2350-Tiny
    Swaps the V2 controller from the Pico 2 to the Waveshare RP2350-Tiny
    (+ panel-mount USB-C adapter over an 8-pin FPC). Adds a hybrid
    solder-down carrier footprint for the module (23 edge + 13 back
    contacts), plus Bourns PEC11L encoder and Kailh Choc V1 footprints and
    an fp-lib-table registering the naub library.
    SKiDL netlist (naub_v2.py) updated to the new part with the pin remap
    (ENC3_SW GP16->GP23, since GP16 drives the onboard WS2812), the
    backlight now on VSYS (USB 5 V over the FPC), and GP29 broken out on the
    expansion header; validates at 42 parts / 48 nets. Docs (PCB_DESIGN §0
    rework status + pin map/power/verification, PCB_NOTES, BOM_V2) brou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
    [naub_v2.py]
2026-07-22 Update V2 netlist: 5 aux buttons, drop J2 expansion header
    BTN5 claims GP22 (was the J2 "spare"), so the aux row is SW5..SW9. The J2
    expansion header is gone: the control set is final and the enclosure is
    sealed, so an internal header bought little while costing 6 traces on a
    crowded 2-layer board. GP26-29 stay reserved by simply being unconnected.
    Committing local working-tree state so the encoder-shield change lands on
    top of a known base.
2026-07-22 Ground PEC11L encoder shields; name every net
    encoder_pec11l() gained an SH pin so the footprint's two plated mounting
    lugs can be reached from the netlist, and the encoder loop ties them to
    GND. They were floating on all four encoders: these are the parts a user
    physically grabs, so ESD into a floating shaft had no path except through
    the encoder contacts into GP0-GP19, and lugs soldered into the pour resist
    twisting far better than lugs in isolated holes.
    Also replaced every implicit net with a named one, so the layout shows
    LCD_SCL / BL_A2 / BTN3 instead of N$12 / N$25 / N$6:
    LCD_SI SCL A0 RST CS, LCD_CAP{1P,1N,2P,2N,3P}, LCD_VOUT, LCD_V0..V4,
    BL_A1..A3, BL_PWM, BTN1..BTN5, SWCLK, SW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
    [naub_v2.py]
2026-07-23 Add V2 KiCad board, project, and schematic to git
    First checkpoint of the layout work, which had been living untracked on
    disk: 47 footprints placed, both GND zones filled, 4× M3 mounting holes,
    56 x ~101.7 mm outline. Connectivity verified node-for-node against
    naub_v2.net (0 mismatches); encoder SH lugs grounded.
    .gitignore restored (it had been deleted) and extended to exclude KiCad
    local/temp files (*.lck, *.kicad_prl, .history/) and Freerouting exports
    (*.dsn), alongside the existing SKiDL-artifact rules. The design source
    (.kicad_pcb/.kicad_pro/.kicad_sch) and the naub.pretty footprint library
    are the tracked source of truth.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
    [naub_kicad.kicad_pcb, naub_kicad.kicad_sch]
2026-07-25 Add naub_v2_layout footprint to naub.pretty
    This footprint is referenced by naub_kicad.kicad_pcb but was never
    committed, so a fresh clone could not resolve it. It carries the V2
    mechanical layout (board outline, encoder/switch/display keepouts and
    centrelines) on Dwgs.User.
2026-07-25 Track CAD DXF layouts; ignore the rest of CAD/
    CAD/ is ~497 MB of Blender scenes, STEP/3MF meshes and vendor model
    downloads — not something to put in git. The DXF layout drawings are the
    exception: they are a few KB each and are the source of the V2 board
    outline and component placement, so they belong in the repo.
    [component_layout.dxf, naub_v2_layout2.dxf, naub_v2_layout3.dxf, naub_v2_layout4.dxf]
2026-07-25 Add bring-up hooks, route the board, document the router
    Takes the V2 board from unrouted to fully routed, plus the debug hardware that
    had to go in first.
    Bring-up hooks (naub_v2.py, 42 parts/44 nets -> 56/50)
    Two 0R rail links (JP_3V3, JP_BL) that strand the display and the backlight
    independently -- the +3V3 and VSYS_5V load lists turned out to be disjoint,
    which is what makes the seams clean. Ten probe pads, two 1x6 debug rows
    (J_LCD on the display bus, J_ADC on the spare GP26-29). Every netlist edit was
    verified electrically inert against the git-HEAD baseline: 39 nets identical
    node-for-node.
    Placement (place_bringup_hooks.py) is kept in the repo as the record of where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
    [naub_kicad.kicad_pcb]
2026-07-25 Re-place the back-side passives and re-route
    The passives had been dropped in convenient clumps rather than placed against
    the pins they serve. The headline defect: C_DEC, the decoupling cap for the
    module's 3V3 rail, sat 22.6 mm from U1's 3V3 pad -- at that distance loop
    inductance swamps the capacitor and it decouples nothing above a few MHz.
    C_DEC -> U1.3V3 22.59 -> 2.59 mm
    C_BULK -> U1.3V3 28.58 -> 6.25 mm
    C_LCD_VDD -> U2.VDD 5.81 -> 1.89 mm
    copper 1120.8 -> 1045.5 mm
    segments/vias 779/24 -> 693/18
    unconnected 0 -> 0
    25 parts moved, UI and mechanical parts held fixed (U2, SW1-9, mounting holes,
    U1, the bring-up hooks). R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
    [naub_kicad.kicad_pcb]
2026-07-25 Record measured verification of the routed board
    No board changes -- this is the evidence for the previous two commits.
    Closes the PCB_DESIGN 4.2 caveat that had been carried since the board was
    first routed ("the router cannot know the charge-pump caps want small loop
    area, go and look"). It was settled not by the router but by fixing the
    placement underneath it. Measured routed copper per net:
    LCD_CAP1N 8.2 -> 1.8 mm LCD_VOUT 6.6 -> 2.0 mm
    LCD_CAP1P 2.0 -> 1.0 mm LCD_V0 13.4 -> 3.1 mm
    LCD_CAP2P/2N 1.5 -> 1.0 mm BL_PWM_GATE 37.5 -> 2.3 mm
    LCD_CAP3P 1.6 -> 1.1 mm
    Every charge-pump net is about a millimetre of copper with its cap on the pin,
    retu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
2026-08-31 Track assembly source and fab export for board bring-up
    Adds fab/assembly.csv (decides which parts JLC places, with values and
    rotations) and export_fab.py (regenerates the BOM/CPL/gerber package into
    the ignored pcb/export/). Also captures the latest routed board, project,
    and footprint edits so the soldered state matches what's on remote.
    Claude-Session: https://claude.ai/code/session_01BDd8G5FsdE3f6Nmztv6QAc
    [assembly.csv, naub_kicad.kicad_pcb]
2026-09-01 Add V2 bring-up log and bench test kit
    Board #1 completed BRINGUP.md Stages 2-5: module accepted, soldered,
    17 inputs verified, ST7565 display and backlight working.
    BRINGUP_LOG.md records what was verified per stage and nine lessons
    learned, the load-bearing ones being:
    - CircuitPython's waveshare_rp2350_tiny board definition exposes no
    board.GP17..GP23, so V2 firmware must reach the back solder-through
    pads (ENC4 A/B/SW, BTN3/4/5, ENC3_SW) via microcontroller.pin.
    - CIRCUITPY is unwritable from both host and board on this setup, so
    all tooling deploys over the REPL instead of the drive.
    - A detentless PEC11L can rest with both contacts closed and read as
    two stuck-low pins while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
    [deploy_repl.py, live_inputs.py, prove.py, reporter.py, run_stage4.py, selftest.py, selftest2.py, stage3_test.py]
2026-09-05 Package the V2 display experiments as a reusable firmware toolkit
    firmware/v2/ lands the grayscale + motion bring-up work in usable form:
    - device/st7565.py: ST7565R driver (EA DOGM128W-6 init, full-frame,
    dirty-span partial writes, FRC-friendly page views). 8 MHz SPI verified;
    ~554 fps full-frame, ~2200 partial updates/s measured.
    - device/naubhw.py: board wiring with the bring-up lessons baked in
    (encoder divisor=2 for the PEC11L, GP17-23 via microcontroller.pin,
    internal pull-ups, tuned display defaults: contrast 31, orient 180).
    - host/frc.py: PC-side FRC grayscale encoder - the recipe the user picked
    on hardware (4 planes, Bayer residual, (x+y)%4 phase), composable per
    regi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
2026-09-05 Track the remaining PCB sources; ignore SKiDL/KiCad debris
    export_3d.py and make_3d_models.py build the enclosure-side 3D output and
    were never committed. pcb/graphics/ holds the logo art that the board
    footprint and firmware/v2/host/gen_icon.py both consume, so it is source.
    The JLCPCB DFM report is not regenerable locally, so it is kept as a record
    of the board that was actually fabricated.
    Ignored instead: the SKiDL .net/.erc/.log/_sklib.py pair that lands at the
    repo root when naub_v2.py runs from there (pcb/.gitignore already covers the
    in-directory copies), and the empty pre-rename "naub" KiCad project shell.
    Claude-Session: https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
2026-09-05 Add the app-switcher carousel, the first V2 UI screen
    A scrollable shelf of app icons: focused one large and black, neighbours
    smaller and grayer, name and position rail below. carousel.py is the
    reusable widget and imports nothing but gfx, so host/preview_switcher.py
    renders the exact code the device runs.
    Two things keep it affordable underneath the FRC plane cycling:
    * Every size tier is a multiple of 8 on a page boundary, so drawing an
    icon is a byte-slice copy and horizontal position is free. A whole
    5-icon, 4-plane frame rebuilds in 1.9 ms.
    * Unfocused icons are dimmed by drawing them into fewer FRC planes,
    which drops their duty cycle. Depth cue with no extra pixel d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
2026-09-05 Add the mixer screen: volume, names and live per-app dot traces
    Three app columns, each with a volume bar, a marquee name and a dot trace
    that scrolls down and fades as it ages; footer carries the preset and
    system volume. The three top knobs are the columns (turn = volume, click =
    open the carousel to pick that column's app, hold = mute) and the
    lower-right knob is system volume.
    On the audio: Windows gives a real per-app level but not a per-app
    spectrum. Every WASAPI session exposes IAudioMeterInformation, so
    host/appmeter.py reads a true amplitude trace per app at ~0.05 ms a
    session. There is no per-session tap for a spectrum -- loopback captures
    the endpoint mix -- so the dots are ampli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
2026-09-05 Make the volume bars binary; add fake-waveform trace styles
    The bars were flickering: their unfilled track was drawn at quarter duty,
    the worst case for FRC, and a large solid area shows the plane cycling far
    more than the trace's small isolated dots do. Bars are now solid in every
    plane or not at all -- range is a 1px baseline instead of a gray track, and
    a muted bar is a hollow outline instead of a dimmer fill. Gray is kept
    where it earns its place: the trace's age fade and the chrome.
    Since Windows gives one number per app per moment and no per-app spectrum,
    the shape of a trace row has to be invented from that number. A row is now
    an 8-bit dot pattern rather than a count, so a style is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
2026-09-05 Rework the dots as an upside-down mixer meter with peak hold
    I had read the sketch as a scrolling time history; it is a level meter.
    Each column now fills from the top downward with the level, and the thin
    continuous line at the leading edge is the peak hold: it jumps straight to
    a new peak and settles back smoothly when the signal drops, detaching from
    the falling bar. Fast-attack/slow-release ballistics on both, with the peak
    falling about six times slower (FALL, PEAK_FALL) -- the asymmetry is what
    makes a meter look alive rather than jittery.
    The trace styles added in the previous commit went with the scrolling
    reading and are gone, along with their Button 1 cycling.
    The 11 fill levels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
    [mixer.py, preview_mixer.py]
2026-09-05 Meter: 8 faked bands per column, pixel-smooth, single-plane binary
    Three changes, all from the same note.
    Smoothness: a band's fill is now any of 0..40 PIXELS rather than one of 10
    dot rows, so the ballistics move at the finest step the panel has. The dot
    texture comes from the fill pattern (2px lit, 2px clear) instead of from
    quantising the height, so it still reads as a dot matrix. Tick raised to
    60 Hz with FALL/PEAK_FALL retuned to match.
    Faked spectrum: each column is 8 independent bands -- a gentle tilt (lows
    louder) times a per-band random walk that is smoothed rather than re-rolled
    each frame, so bands drift and bounce independently instead of looking like
    static. Each band carries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
    [mixer.py, preview_mixer.py]
2026-09-05 Flip the meter upright; go live on real audio; fix the column offset
    Meter now stands on the floor and bounces up, with the peak markers
    hanging above and settling down onto it. The dot texture is anchored to
    the bottom too, so the dots stay put as a bar grows instead of crawling.
    Live audio: device/boot.py enables the second USB CDC interface and
    device/link.py speaks the V1 line protocol over it, because host->device
    writes on the console port hang on this board. host/naub_bridge.py streams
    the real WASAPI per-app levels (new `meter` verb) and applies knob moves
    back to Windows. demo_mixer.py runs either way -- it simulates until a host
    talks to it. Verified against Spotify: the device no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
    [appmeter.py, boot.py, deploy.py, link.py, mixer.py, naub_bridge.py, st7565.py]
2026-09-05 Plan the detentless PEC11L-4015F-S0020 for the next revision
    Records the encoder change agreed for the build after this one, without
    touching the current V2 pick. The detented PEC11L reads as rough and
    clicky; detent code 0 plus the Nyogel 767A damping grease replaces the
    click with weight.
    PEC11L-4015F-S0020 is detent code 0 (no detents), 20 PPR, 6 mm flatted
    15 mm shaft, push switch retained.
    No board work. The in-repo footprint
    naub:RotaryEncoder_Bourns_PEC11L-4xxxF-Sxxxx_Vertical is variant-agnostic
    by design -- detent code, shaft length and resolution change no physical
    dimension -- so pads, netlist, pin map and the 5.0 mm body height all
    carry over unchanged.
    Knock-ons captured so t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
2026-09-05 App switcher: a dropdown out of the column's own name slot
    Replaces the standalone carousel screen. Clicking a column knob drops a
    40px panel over the meter band (pages 2..6); the volume bars and the footer
    never move, and the column being edited is the one whose name and rule are
    missing -- the gap is what the panel appears to come out of.
    Three parts, updated at three different rates, which is why the panel is
    built page by page: a ring per app with a live audio session (filled at the
    selection), a shelf of icons at 24px focused / 16px either side, and a row
    carrying the selected app's name and a horizontal level meter with a peak
    tick. The meter follows the scroll, not the column, so y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
2026-09-05 Host: stream the live app list, and pin a column the switcher picks
    The switcher's counter is meant to be the number of apps making noise, so
    the host now sends the whole active-session list (`apps A,B,C`, comma
    separated because process names can contain spaces) and a level per entry
    (`ameter`) alongside the per-column `meter`.
    `pick <ch> <APP>` comes back when a column is assigned, and the host pins
    that column: it stops handing it to whatever the busiest three sessions
    happen to be. That closes the question left open last pass, where a manual
    choice was overwritten the moment the top three changed.
    Verified end to end against a real WASAPI session: apps/columns/meters flow,
    the device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
    [appmeter.py, deploy.py, drawer.py, gen_switcher.py, link.py, naub_bridge.py, preview_drawer.py]
2026-09-05 Taller mode bar, mode flipping, and the media keys
    The bottom bar is two pages now so its text is not jammed against the rule,
    and it names the current MODE rather than a fixed preset. The `|||` beside
    the label turns out to be load-bearing: it is the position in the mode list.
    One tick fewer than there are modes, split by the current one -- ticks left
    of the label are the modes behind you, ticks right the ones ahead, so
    `|| CUSTOM 1 |` reads as third of four without counting anything. Flipping
    redraws the bar and that is the whole transition; there is nothing to
    animate, which is exactly why it feels instant.
    BTN1/BTN2 flip the modes. Only APP CTRL has a screen -- EQ and CUSTOM 1/2
    move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
    [appmeter.py, deploy.py, drawer.py, media.py, mixer.py, naub_bridge.py, preview_drawer.py]
2026-09-05 Pin the mode ticks to a lattice; stop inventing audio levels
    Three fixes.
    The mode ticks were flowing around the label, so a longer name pushed them
    sideways -- which defeats the entire point of them. They are a position
    indicator and must be read positionally. Now they sit on a fixed lattice:
    n slots in a row, n-1 holding a tick and one holding the label, and advancing
    a mode swaps the label with the tick on its right. The label is
    left-justified in a field as wide as the longest mode name, so exactly two
    things move -- one tick hops to the other side, and the label's leading edge
    steps right by exactly the space that tick now occupies. The left ticks are
    always at x=1,4,7 and the last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
    [mixer.py, naub_bridge.py]
2026-09-05 Reclaim the icon size; animate the mode ticks
    The switcher's icons are back to 24px focused / 16px either side inside a band
    only three pages tall, by rearranging rather than by taking pixels from the
    mode bar:
    * the name gets the WHOLE width. It is the selected app's name, not a column
    heading, so nothing needs to share the row and a long name has all 128px
    before it is trimmed.
    * the shelf is TOP-aligned rather than bottom-aligned. Every tier starts on
    the same page and the focused one simply reaches further down, which is
    what lets 24px and 16px coexist in 24px of band.
    * the counter and the level meter FLANK the focused icon instead of sitting
    under it, in th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
2026-09-05 One-page mode bar, 40px meter, centred bands, bigger icons
    The bottom bar is one page now, matching the app label bar exactly: both are
    8px, and each carries its rule on the row that divides it from the meter --
    the names bar at the bottom of its own page, the mode bar on the last row of
    the meter band. That makes the rule above the mode bar free again (the
    meter's scratch clears its final page TO it), and the label is pushed down a
    row so it clears that rule the way the names bar leaves a row above its own.
    The ticks now run the bar's full height, hanging off the rule.
    The page the bar gave up goes to the meter, which is 40px again, and to the
    switcher, whose icons grow to 32px focused /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
2026-09-05 Switch to Tahoma; left-justify the app labels
    Tahoma at size 8 cropped from row 1 gives the same 6px caps in the same one
    page, and renders SPOTIFY in 32px against the old face's 31 -- so no column
    fit or marquee threshold moved. gen_font.py now takes --face (tahoma default,
    redalert and four others on offer) and --list.
    Getting there turned up a real bug in the rasteriser, which had been there
    since the font was first generated and was invisible only because the old face
    never triggered it: the canvas was sized to the glyph's ADVANCE and drawn at
    x=0, so any ink overhanging the advance on the right, or starting left of the
    pen origin, was clipped. A proportional face does both -- Tahoma'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
    [gen_font.py, mixer.py, preview_fonts.py, preview_mixer.py]
2026-09-05 Plan: what parametric EQ would actually take
    Writes up the EQ mode the mode bar has been reserving, grounded in what is
    really on this machine rather than in estimates.
    The conclusion is not to write any DSP. Equalizer APO is already a parametric
    EQ engine inside the Windows audio pipeline, it is installed here and attached
    to two endpoints, and the V1 host already drives the three-band fixed version
    of exactly this -- so the work is a config writer, four protocol verbs and a
    screen, none of them signal processing.
    Two measurements shape the design, and both were taken rather than guessed:
    * writing our config file costs 0.26 ms median, but every write makes
    Equalizer APO re-parse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
2026-09-05 Use a font actually drawn at this pixel size
    Tahoma was still an outline being crushed onto a 5-6px cap height, and it
    showed: strokes dropped, others merged, the 'A' arriving with no crossbar. No
    amount of hinting fixes that -- the fix is a face someone drew at this size.
    Windows ships seven RASTER faces, and PIL/FreeType cannot open a .FON at all,
    which is why the first survey never saw them. host/gdifont.py renders text
    through GDI instead, with NONANTIALIASED_QUALITY, so what comes back is
    precisely the glyph bitmap the face defines -- no greys, nothing to threshold.
    TINY is now Small Fonts at height 8: an 8-row cell, i.e. exactly one page, 5px
    caps, and SPOTIFY in 29px against 31 fo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
    [gdifont.py, gen_font.py, preview_fonts.py]
2026-09-05 EQ: everything except the screen
    Prepares the EQ mode so the only thing left is the layout.
    device/eqcurve.py -- the curve. Summed magnitude of N biquads at the 128
    columns, evaluated analytically on the unit circle with the trig precomputed
    once per column and magnitudes kept squared so the logarithm happens once per
    column rather than once per band. RBJ cookbook coefficients, which is what
    Equalizer APO implements, so the plot is the response the audio actually gets
    rather than an illustration of one. Checked against an independent numpy
    evaluation: peaking bands match to 2e-11 dB, shelves reach their asymptotes,
    bands sum in dB, and an incremental update is bit-identical to a rebuild.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
2026-09-05 EQ mode: the screen
    Built to the sketch. Three bands in the mixer's own three-column frame --
    three top knobs, so three bands -- over a filled response curve.
    0 dB is the vertical middle of the plot, as asked, so flat is a straight line
    across the centre and the curve reads as deviation in both directions. The
    plot is 48 rows (pages 1-6) so the centre lands on a row rather than between
    two. The dot fill hangs from the curve down to the floor on a grid anchored to
    the BOTTOM, so the dots stay put as the curve moves instead of crawling with it
    -- the same reasoning as the meter bands -- and every curve height is
    precomputed as page masks, so drawing a column is six byte writes rather than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
2026-09-05 Survive the audio endpoint changing; EQ is live and proven
    The bridge died with COMError 'Access is denied' from GetAllSessions. Cause:
    the default endpoint was torn down and recreated underneath it -- which is a
    routine event (headphones going in, a Bluetooth speaker connecting, the
    Equalizer APO configurator doing its work), not a fault. A panel that goes
    dark because someone plugged in headphones is a bad panel.
    AppMeters.refresh() now returns False instead of raising when WASAPI is
    mid-change, keeping the previous session map so levels stay callable, and the
    bridge rides it out and retries. SysMeter.restart_if_dead() reopens the
    loopback capture on the new default, since that thread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
2026-09-05 Fix the screen going dark: views, plane count and index must move together
    Symptom: the panel went black a few seconds after use, surviving replugs.
    Cause: an unhandled IndexError in the frame loop, which stops code.py and with
    it the display.
    The loop shows views[i] and advances i until it reaches n_planes, so those
    three have to agree. They were being set in five different places, and caught
    in the act the state was i=4 against a 1-plane screen -- the drawer's four FRC
    planes outliving the drawer. A stale index is enough to take the whole panel
    out, because nothing was catching it.
    Every screen change now goes through set_screen(), which sets views, n_planes
    and i as one operation, and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
2026-09-05 The EQ never actually EQ'd anything, and that also caused the freeze
    Three bugs, one of them the whole feature.
    1. Every filter was written `Filter: OFF ...`. eqapo.Band defaulted on=False
    and the device only ever sends `eqp <i> gain`, so nothing ever turned a band
    on. Equalizer APO dutifully ignored all of them. The panel drew the curve
    the whole time, which is exactly why this went unnoticed -- drawing a curve
    proves nothing about the sound. Bands are ON by default now; a 0 dB filter
    is already a no-op, so `on` is reserved for deliberately parking one.
    The host's defaults were wrong too: five bands of PK at 1 kHz, pushed to the
    device on connect, against a screen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
    [eqapo.py]
2026-09-05 EQ reset key, no transport in EQ mode, and directional eased wipes
    The bottom-left keyswitch resets the EQ while in EQ mode, and the other two
    bottom keys are unmapped there: a transport key is no use with your hands on
    the EQ, and a reset is. Media transport is unchanged everywhere else.
    Reset means the whole default profile, not just the gains -- shapes back to
    LOW/MID/HIGH too, because a "flat" that leaves a band parked at some frequency
    you no longer remember is not much of a reset. The host's flat() now does the
    same thing, so the two cannot disagree about what flat means.
    The mode wipe is eased rather than linear, taking a fixed fraction of the
    remaining distance each frame like th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
    [eqapo.py, wipe.py]
2026-09-05 Stop the host appearing in its own mixer
    sysmeter's loopback capture opens the render endpoint, and Windows registers
    that as an audio session -- so the bridge showed up in its own app columns as
    "python", with a level that mirrored the system output it was busy capturing.
    appmeter now skips its own PID. By process id rather than by name, so another
    Python program playing audio is still a source like anything else; it is only
    naub that should not be one.
    Confirmed: the phantom session was pid 43612, which was naub_bridge.py itself.
    Columns now read "spotify | - | -" where they read "spotify | python | -".
    [appmeter.py]
2026-09-05 Backlight that dims and sleeps, and stop redrawing what has not moved
    Full while you are using it, 10% a minute after the last knob or key, off
    after five, fading between the three (device/idle.py). Down takes 1.2 s and
    up takes 0.10 s, because settling should be unhurried and waking should feel
    like a response to what you just did. Any knob or key wakes it AND does what
    it was pressed for -- a mixer you have to poke twice is worse than one that is
    dim.
    The fade interpolates in perceptual space rather than PWM duty: duty IS
    luminance, perceived brightness goes as luminance ** 1/2.2, so a straight line
    in duty looks like it plummets and then dawdles. Backlight.set() now takes
    floats for t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
2026-09-05 Write down the panel's real refresh ceiling: ~77 Hz
    Asked whether the display is capped in hardware, and it is, well below
    anything we have been measuring. The ST7565R scans the glass off its own RC
    oscillator -- fOSC 20 kHz typ, 17..24 min/max -- and at the 1/65 duty this
    panel uses, fFR = fOSC / (4 * 65) = 76.9 Hz typ, 65..92 Hz over tolerance
    (datasheet Tables 19 and 23). Free-running, unsynchronised to our writes, and
    not adjustable: an external clock would need CL/CLS and the DOGM128 module does
    not bring those out.
    So every SPI number in here is data delivery, not refresh. At 360 fps we
    rewrite the RAM ~4.7 times per displayed frame. It also means the 16 ms UI
    tick is already with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
    [st7565.py]
2026-09-05 Pace the frame loop to the panel, and fade the backlight over 3 s
    The glass refreshes at 77 Hz typ / 92 Hz at the fast end of tolerance, so a
    loop free-running at 359-390 fps was rewriting the controller's RAM about five
    times for every frame anyone could see. Paced to 92.3 Hz -- the top of the
    tolerance, so a fast part is still fed everything it can display -- and the
    remainder is slept. Measured: 92.4 Hz.
    Paced per PUSH, not per cycle: with FRC grayscale the grays ARE the share of
    time each plane spends on screen, so idling at the end of a cycle would hold
    the last plane through the gap and tint them. One plane, one slot.
    Timed in monotonic_ns, and this was the whole fight. time.mono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
    [idle.py]
2026-09-05 Put every clock in the frame loop on monotonic_ns
    Chasing why the paced loop ran at 96.2 Hz instead of 92.3 turned up something
    worth more than the 4%: this build uses SINGLE-precision floats (2.0**1023 is
    inf; at 5700 s uptime t + 1e-6 == t), and time.monotonic() is a float of
    seconds since boot. Its granularity is therefore the float spacing at the
    current uptime, and that DOUBLES every time the uptime doubles -- measured
    0.488 ms at 1.5 h, so ~1 ms at 3 h, ~8 ms after a day, ~125 ms after a week.
    On a device that lives plugged into a desk, that is not a rounding error, it is
    a 16 ms tick that stops being a tick. The meter ballistics, the marquee,
    hold-to-mute, the host liveness timeout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
    [idle.py]
2026-09-05 One app one column, assignments that outlive it, and a wheel of its own
    Three things the switcher got wrong, and a look at what belongs where.
    ONE APP, ONE COLUMN. Assigning an app that another column is pinned to now
    swaps the two rather than showing it twice -- two columns driving one session's
    fader would fight, and whichever lost would look broken. Only PINNED
    collisions swap: a column that merely happens to be showing the app has nothing
    to trade, and pinning the app elsewhere drops it out of the auto pool so that
    column picks the next busiest by itself. The device does the swap on its own
    display the instant you confirm and the host does the same to its pins; they
    agree because bot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
    [deploy.py, link.py, naub_bridge.py, sysmeter.py, wheel.py]
2026-09-06 Meter the session you can actually hear, and let the peak markers breathe
    DISCORD. It runs six processes and holds a render session from more than one
    of them: measured in a call, pid 5724 ACTIVE with a peak of 1.0 alongside pid
    14168 idle at 0.0. appmeter keyed a dict by program name and ASSIGNED into it,
    so it kept whichever the enumeration returned last -- measured six times out of
    six, the idle one. Hence an app that appears in the list (its UI-sound session
    blips Active when you join a channel), never shows a level, and ignores the
    knob because the fader being moved belongs to a session nobody can hear.
    Sessions are now grouped per program: the level is the loudest of them and a
    vol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
2026-09-06 The CONFIG screen: settings in tabs, driven by the three knobs
    The fourth mode, replacing CUSTOM 2. Three knobs, three jobs, labelled across
    the top of the screen because that is the affordance: ENC1 the tabs, ENC2 the
    cursor, ENC3 the focused value -- turned live, no arming, no commit. A hidden
    edit mode is what makes people change settings they did not mean to, and there
    is no room on 128x64 to show which state you are in.
    A setting is a tuple and adding one is a line: (name, kind, key, spec, default,
    art). One function knows what a kind looks like, one more knows what a detent
    does to it, and nothing else has a special case. `key` is a string from the
    start because the row order will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
2026-09-06 CONFIG_MENU.md, and the two warts it would have had to document
    Writing the guide turned up two things that would have been documented
    instead of fixed.
    The degree sign was keyed off WHICH ART TUPLE a row used -- `r[5] is
    ANGLE_ART` -- so the only way to get a unit on a setting was to give it the
    view angle's pictures. And PCT hard-coded a percent sign onto every numeric
    row, so KNOB STEP read "4%" when it is a number of detents.
    Both are now one field: `unit`, drawn after the value, a string through the
    font or a strip of column bytes for the ones ccfont has no glyph for (DEG,
    which is why the mechanism has to take both). PCT becomes NUM, which is what
    it always was. METER RATE is now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
    [config.py]
2026-09-06 ADVANCED DISPLAY: the bring-up registers, live, behind a submenu
    The ST7565R controls that stage 4 of bring-up swept by hand to get a picture
    at all -- contrast (0x81), resistor ratio (0x20|n), bias (0xA2/0xA3), booster
    (0xF8), invert (0xA6/0xA7), all-pixels-on (0xA4/0xA5) and start line (0x40|n)
    -- are now a submenu under DISP, entered with a SELECT click. They are live:
    turning the knob writes the register, because a calibration control you have to
    reflash to try is not one. Swept every value of every one on the hardware,
    zero failures, and the panel comes back from all of them.
    Two can black the panel out (contrast 0, ALL PIXELS ON). The cursor does not
    move when they do, so the way b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
    [config.py, idle.py, preview_config.py]
2026-09-06 The view angle is the contrast register, and a SHADING row to go with it
    CONTRAST defaults to 25 now, in the menu and in the driver, so the row and the
    chip agree from boot. Everything else keeps the value it had.
    DISPLAY VIEW ANGLE is that register and nothing else: measured 25 looking down
    at the panel on a desk and 40 from an extremely shallow angle, interpolated
    over the nine steps (40 38 36 34 33 31 29 27 25). Its default moves to 90 deg
    so it lands on 25 -- a friendly row that disagreed with the raw one at boot
    would be worse than no friendly row.
    The two are kept in agreement BOTH ways: setting the angle writes CONTRAST, and
    turning CONTRAST by hand moves the angle row to whatever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
2026-09-06 A waving flag for SHADING, and the list scrolls smoothly
    THE PATCH. A black-to-white ramp, dithered, inside a band displaced by a sine,
    quantised to that mode's level count -- two levels give a hard edge across the
    middle, five pass for a gradient at 30 pixels wide. Two details it needed,
    both found by drawing it wrong first: the band is OUTLINED, because without one
    the flag dissolves wherever the ramp goes light and reads as a blob fading out
    rather than a shape; and the outline is JOINED column to column, because a sine
    sampled per column steps more than a pixel and leaves a dotted trail otherwise.
    SMOOTH SCROLLING. The window eases toward the row the cursor is on, so for a
    dozen fram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
    [config.py, preview_config.py]
2026-09-06 The shading flag waves, and shows the real FRC greys
    TWO REQUIREMENTS, one consequence. The wave cycles while the row is
    highlighted: 16 phases, ~0.9 s round, and the phase only advances when that row
    is the one you are looking at. And the gradient is host/frc.py's encoder
    transcribed onto the device -- integer duty, 4x4 Bayer on the fractional
    residual, phase rotated by (x+y)%n -- rather than an approximation of it,
    because the point of the patch is to show what the switcher's icons will look
    like and the icons are that function's output.
    Which means the config screen now runs FOUR FRC PLANES. The greys only exist
    across the cycle; a one-plane screen could only ever show an impression.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
2026-09-06 Fix the mode bar flickering behind the flag, and write down where V2 stands
    THE FLICKER. sync_foot() copied the mixer's mode bar into cfg.planes[0] and
    only that one. The config screen runs four FRC planes whenever the shading
    flag is on screen, so the bar was being shown on one frame in four -- a 25%
    duty at 21 Hz, which is not a dim mode bar but a flickering one. It now writes
    every plane.
    Audited the rest of the screen the same way rather than fixing just the symptom:
    with the flag up, pages 3 and 4 are the only ones that differ between planes,
    which is exactly the two the flag occupies. Nothing else was being written to
    plane 0 alone.
    STATUS.md is new: what landed since the font ch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
2026-09-06 Thicker wipe edges, and stop the frame pacing retiming animations
    The line leading a wipe was one pixel, and at the panel's new default
    contrast of 25 -- the top-down end of the view-angle range -- a single
    column of ink present for one animation step is most of the way to
    invisible. Both leading edges are EDGE_W = 2 px now, the extra column
    added BEHIND the line so the old/new boundary stays where the maths puts
    it and the thickness reads as a trail. One constant, in wipe.py, because
    the mode change and the drawer must agree.
    The rest of it was the pacing. Every eased animation here is a fraction
    of the remaining distance applied once a frame, which states a speed per
    FRAME rather than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
2026-09-06 Write down the 2 px edge and the 46 Hz the meters actually run at
    The README claimed the redraws update at 62.5 Hz "however fast the loop
    spins", which is wrong twice: the 16 ms gate is only tested once a frame,
    so it has always fired later than that, and how much later depends on
    exactly the thing the sentence says it does not.
    Claude-Session: https://claude.ai/code/session_01X5WWM6bQvFCQiQuzkf8UNP
2026-09-06 What porting the host to macOS would actually take
    A study, not a plan of record; no port code was written. Short version:
    the transport, deploy, bridge loop, system volume and build-time tooling
    port in about a week and need nothing installed. Everything that makes
    naub a mixer does not.
    Three findings carry it. macOS has no free per-app peak meter -- a tap
    object exposes UID/Description/Format and a process object exposes
    PID/BundleID/Devices/IsRunning/IsRunningOutput, and none of those is a
    level -- so metering an app means capturing its PCM and computing the
    peak, which inverts this project's "push work onto the device" trade.
    Per-app volume has no API at all; the only mechanism is t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
2026-09-06 A GITHUB page on the SYS tab, and a CARD kind to hang it on
    CARD is a page that is a picture rather than a list. Entering and
    backing out are PAGE's exactly, and what makes it different is one
    line: a card's view has no rows. Everything that walks rows then
    finds none, so the cursor, the scrollbar, the value knob and the
    shading overlay all correctly do nothing without any of them being
    told that cards exist. draw_list branches once and a card is a
    single 640-byte copy, cheaper than the list it replaces.
    The page shows the repo's QR beside the link it encodes. Both, not
    either: the code is the point on a panel with no keyboard, but a QR
    is unreadable to a person, so if it will not scan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
    [config.py, deploy.py, gen_qr.py]
2026-09-07 Make naubd the V2 daemon: port the bridge to proto=2, retire V1
    The always-on process was still the V1 daemon -- proto=1, four configured
    channels, e-paper icons -- while the device it autostarts against has been
    V2 for months. It now speaks proto=2 and drives the V2 mixer panel.
    Ported from firmware/v2/host/naub_bridge.py, all of it: per-app WASAPI
    metering across every render endpoint (audio.rs), the three-band parametric
    EQ into Equalizer APO (eqapo.rs), the loopback capture and its spectrum
    (sysmeter.rs, with a radix-2 FFT so the single-binary story survives numpy),
    column pins (pins.rs) and the orchestration (bridge.rs). The Python bridge
    stays as the development tool; the two share pi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
2026-09-08 Stop the daemon corrupting a line, and the device dying when it does
    The board was dropping to the REPL after a while: dead panel, no meters, no
    knobs. The console had it:
    File "code.py", line 639, in <listcomp>
    ValueError: invalid syntax for integer with base 10
    Line 639 is the smeter handler and the token it choked on was `5hello` -- a
    half-written line with the next one glued onto it.
    The cause was mine, from the proto=2 port. serialport-rs has ONE timeout for
    both directions and I set it to 10 ms; naub_bridge.py uses timeout=0 for
    reads and write_timeout=0.5 for writes, so the daemon's write timeout was
    fifty times shorter than the Python's. At that length resync()'s burst tim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
    [bridge.rs, conlog.py, link.rs]
2026-11-08 Port naubd to macOS, attach the EQ from the tray, push app icons
    macOS (type-checked for both Mac targets from Windows, never linked or
    run; naubd/macos/TESTING.md is the test plan):
    - Split naubd by platform: cfg-selected audio and tray, target-specific
    windows/winreg dependencies, a neutral error from Bridge::new.
    - audio_mac.rs: one process tap, private aggregate and IOProc per app, on
    a worker thread. An app at 100% with a flat EQ is only metered; moving
    its knob mutes it at the source and renders a gain-scaled copy. Nothing
    is muted until a real sample proves the capture grant, and fatal signals
    plus a startup sweep keep a muted tap from outliving the daemon.
    - dsp.rs: the rea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
    [admin.rs, appicon.rs, appkey.rs, audio.rs, audio_mac.rs, bridge.rs, build.rs]
2026-11-08 Stop the daemon leaking 60 MB an hour in its session refresh
    naubd reached 2.37 GB private after 39 hours. Audio::refresh built the new
    session map while the old one was still alive and then swapped them, and
    calling GetSessionEnumerator while the last pass's session objects are held
    leaks inside the audio stack, in proportion to the sessions held. Nothing in
    our code loses track of anything, and each call is clean on its own: only the
    overlap leaks.
    Clear the map before enumerating. Taking the enumerators first and dropping
    the old map before walking them still leaks (~9.4 KB a pass), so the old
    sessions have to be gone before GetSessionEnumerator is called.
    The cost: when enumeration fai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
    [audio.rs]
2026-11-08 Stop the daemon spinning through the last millisecond of every meter
    naubd sat at 4% of a core, 90% of it kernel time. The loop slept until 1 ms
    before the next meter and did not sleep at all inside that millisecond, so it
    spun there 50 times a second, making a serial poll per pass. No part of the
    loop's work was expensive: switching off writes, reads, level polling or the
    1 Hz refresh each left the figure where it was, because none of them was the
    spin.
    Sleep the whole remainder instead. The meter is a display feed and does not
    care about a millisecond; the longest sleep is still MAX_WAIT, so knob latency
    is unchanged.
    Measured from cycle counters, switching between the two in one connect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
